jorikdima/sdr-pcb/BOM_sdr.xls

Sheet: bom_full
RefDes | Manufacturer | Manufacturer Part Number | Digi-Key Part Number | Quantity | Description
C1,C101,C107,C109 | YAGEO (VA) | CC0603KRX5R6BB475 | 311-1455-1-ND | 4 | CAP CER 4.7UF 10V X5R 0603
C2,C4,C10-C13,C19,C64-C67 | YAGEO (VA) | CC0603KRX7R7BB474 | 311-1428-1-ND | 11 | CAP CER 0.47UF 16V X7R 0603
C21,C22,C86,C87,C90-C93,C110,C111 | JOHANSON TECHNOLOGY INC (VA) | 251R14S200GV4T | 712-1329-1-ND | 10 | CAP CER 20PF 250V C0G/NP0 0603
C26,C72,C74,C75, C78, C79 | TDK CORPORATION (VA) | C2012X5R1C106K085AC | 445-7644-1-ND | 6 | CAP CER 10UF 16V X5R 0805
C28,C29,C37,C80-C83,C85 | MURATA ELECTRONICS (VA) | GRM188R61C105KA93D | 490-1536-1-ND | 8 | CAP CER 1UF 16V X5R 0603
C3,C5-C9,C14-C18,C20,C23-C25,C27,C30-C33,C35,C36,C38-C40,C44,C46-C48,C50-C53,C55,C57-C63,C84,C88,C102-C104,C106,C108 | YAGEO (VA) | CC0603KRX7R7BB104 | 311-1088-1-ND | 48 | CAP CER 0.1UF 16V X7R 0603
C34,C54,C68-C71 | AVX CORPORATION (VA) | 0603YC330JAT2A | 478-6211-1-ND | 6 | CAP CER 33PF 16V X7R 0603
C41,C43 | KEMET (VA) | C0603C471K3RACTU | 399-9086-1-ND | 2 | CAP CER 470PF 25V X7R 0603
C42,C45,C105 | MURATA ELECTRONICS (VA) | GRM188R71E103KA01D | 490-1520-1-ND | 3 | CAP CER 10000PF 25V X7R 0603
C49,C56 | KEMET (VA) | C0603C151K3GACTU | 399-9008-1-ND | 2 | CAP CER 150PF 25V C0G/NP0 0603
C73,C100 | KEMET (VA) | CBR06C689CAGAC | 399-8719-1-ND | 2 | CAP CER 6.8PF 250V C0G/NP0 0603
C76,C77,C94 | AVX CORPORATION (VA) | 0603YC101KAT2A | 478-6207-1-ND | 3 | CAP CER 100PF 16V X7R 0603
C89,C95-C99 | MURATA ELECTRONICS (VA) | GQM1885C2A3R6CB01D | 490-8135-1-ND | 6 | CAP CER 3.6PF 100V C0G/NP0 0603
D1,D2 | INFINEON TECHNOLOGIES (VA) | ESD0P8RFL E6327 | ESD0P8RFLE6327INCT-ND | 2 | TVS DIODE 50VWM 15VC TSLP4
D3 | DIALIGHT | 5512509F | 350-1682-ND | 1 | LED 3MM RTANG HI EFF ORANGE PCMT
D4 | DIALIGHT | 5510209F | 350-1665-ND | 1 | LED 3MM RT ANG HI EFF GRN PC MNT
D5 | LITE-ON INC (VA) | LTST-C190GKT | 160-1183-1-ND | 1 | LED GREEN CLEAR 0603 SMD
D6 | LITE-ON INC (VA) | LTST-C190EKT | 160-1182-1-ND | 1 | LED RED CLEAR 0603 SMD
D7 | ON SEMICONDUCTOR (VA) | ESD7016MUTAG | ESD7016MUTAGOSCT-ND | 1 | TVS DIODE 5VWM 10VC 8UDFN
J1,J2 | MOLEX, LLC | 0732511150 | WM5534-ND | 2 | CONN SMA RCPT STR 50OHM EDGE MNT
JP1,JP2 | MOLEX, LLC (VA) | M20-9960245 | 952-2244-ND | 2 | CONN HEADER 20POS .100 R/A TIN
L1,L3,L13,L14 | MURATA ELECTRONICS (VA) | BLM18KG601SN1D | 490-5258-1-ND | 4 | FERRITE BEAD 600 OHM 0603 1LN
L2,L6,L7,L10 | MURATA ELECTRONICS (VA) | LQW18AN36NG00D | 490-6886-1-ND | 4 | FIXED IND 36NH 400MA 260 MOHM
L4 | MURATA ELECTRONICS (VA) | LQH3NPN2R2MMEL | 490-15950-1-ND | 1 | FIXED IND 2.2UH 2.1A 78 MOHM
L5 | ABRACON LLC (VA) | ASPI-4030S-4R7M-T | 535-12322-1-ND | 1 | FIXED IND 4.7UH 2A 60 MOHM SMD
L8,L9,L11,L12 | ABRACON LLC (VA) | AIMC-0603-2N7S-T | 535-11536-1-ND | 4 | FIXED IND 2.7NH 500MA 100 MOHM
R1 | YAGEO (VA) | RC0603FR-071K6L | 311-1.60KHRCT-ND | 1 | RES SMD 1.6K OHM 1% 1/10W 0603
R10,R12,R40,R41 | YAGEO (VA) | RC0603JR-07820RL | 311-820GRCT-ND | 4 | RES SMD 820 OHM 5% 1/10W 0603
R11,R13 | YAGEO (VA) | RC0603JR-071K2L | 311-1.2KGRCT-ND | 2 | RES SMD 1.2K OHM 5% 1/10W 0603
R14,R38,R39 | YAGEO (VA) | RC0603JR-07390RL | 311-390GRCT-ND | 3 | RES SMD 390 OHM 5% 1/10W 0603
R16 | YAGEO (VA) | AC0603JR-076K8L | YAG3686CT-ND | 1 | RES SMD 6.8K OHM 5% 1/10W 0603
R2,R26,R28,R30-R32,R37 | YAGEO (VA) | RC0603JR-0710KL | 311-10KGRCT-ND | 7 | RES SMD 10K OHM 5% 1/10W 0603
R22,R23 | YAGEO (VA) | RC0603FR-07120KL | 311-120KHRCT-ND | 2 | RES SMD 120K OHM 1% 1/10W 0603
R24 | YAGEO (VA) | RC0603FR-07100KL | 311-100KHRCT-ND | 1 | RES SMD 100K OHM 1% 1/10W 0603
R25 | YAGEO (VA) | RC0603FR-07560KL | 311-560KHRCT-ND | 1 | RES SMD 560K OHM 1% 1/10W 0603
R3,R17-R20,R27 | YAGEO (VA) | RC0603JR-071KL | 311-1.0KGRCT-ND | 6 | RES SMD 1K OHM 5% 1/10W 0603
R35 | YAGEO (VA) | RC0603JR-072KL | 311-2.0KGRCT-ND | 1 | RES SMD 2K OHM 5% 1/10W 0603
R15,R36 | YAGEO (VA) | RC0603FR-0712KL | 311-12.0KHRCT-ND | 2 | RES SMD 12K OHM 1% 1/10W 0603
R42-R45 | YAGEO (VA) | RC0603JR-070RL | 311-0.0GRCT-ND | 4 | RES SMD 0.0OHM JUMPER 1/10W 0603
R4-R7,R29 | YAGEO (VA) | RC0603JR-074K7L | 311-4.7KGRCT-ND | 5 | RES SMD 4.7K OHM 5% 1/10W 0603
R9,R21,R33,R34 | YAGEO (VA) | RC0603JR-0722RL | 311-22GRCT-ND | 4 | RES SMD 22 OHM 5% 1/10W 0603
S1 | HARWIN INC (VA) | S1711-46R | 952-1475-1-ND | 4 | RFI SHIELD CLIP TIN SMD
SW1 | C&K (VA) | KMR231NG LFS | CKN10246CT-ND | 1 | SWITCH TACTILE SPST-NO 0.05A 32V
T1,T2 | ANAREN MICROWAVE INC (VA) | B0322J5050AHF | 1173-1051-1-ND | 2 | XFRMR BALUN RF 300-2200MHZ 0805
T3,T4 | MINICIRCUITS | TR_TC1-1-43X+ | TR_TC1-1-43X+ | 2
TP1,TP2 | KEYSTONE ELECTRONICS | 5029 | 36-5029CT-ND | 2 | PC TEST POINT MINI SMD
U1 | FTDI | FT601Q-B-T | 768-1311-ND | 1 | IC USB3-32BIT SYNC FIFO 76QFN
U10 | MICROCHIP TECHNOLOGY (VA) | MIC94310-JYMT-TR | 576-4124-1-ND | 1 | IC REG LDO 2.5V 0.2A 4TMLF
U12,U13 | INFINEON TECHNOLOGIES (VA) | BGS12PL6E6327XTSA1 | BGS12PL6E6327XTSA1CT-ND | 2 | IC SWITCH RF SPDT TSLP6-4
U14 | FTDI (VA) | FT232HL-REEL | 768-1101-1-ND | 1 | IC HS USB TO UART/FIFO 48LQFP
U15 | MICROCHIP TECHNOLOGY (VA) | 93LC56BT-I/OT | 93LC56BT-I/OTCT-ND | 1 | IC EEPROM 2KBIT 2MHZ SOT23-6
U3 | LIME MICROSYSTEMS LTD (VA) | LMS6002DFN | 1434-1000-1-ND | 1 | IC RF TXRX CELLULAR 120-VFQFN
U4 | LATTICE SEMICONDUCTOR CORPORATION | LFE5U-25F-6BG381I | 220-2052-ND | 1 | IC FPGA 197 I/O 381CABGA
U5 | SILICON LABORATORIES INC | SI5351A-B-GT | 336-2399-5-ND | 1 | IC CLK GENERATOR 200MHZ 10MSOP
U6,U11 | DIODES INCORPORATED (VA) | PAM2305DABADJ | PAM2305DABADJDICT-ND | 2 | IC REG BUCK ADJ 1A SYNC TSOT25
U7 | STMICROELECTRONICS (VA) | LD39200PU33R | 497-15229-1-ND | 1 | IC REG LINEAR 3.3V 2A 6DFN
U8,U9 | MICROCHIP TECHNOLOGY (VA) | MIC94310-GYMT-TR | 576-4012-1-ND | 2 | IC REG LDO 1.8V 0.2A 4TMLF
X1 | AMPHENOL COMMERCIAL PRODUCTS (VA) | GSB443133HR | GSB443133HRCT-ND | 1 | USB3.1 MICRO B R/A SMT 30U
X2 | SULLINS CONNECTOR SOLUTIONS (VA) | GRPB081VWVN-RC | S9014E-08-ND | 1 | CONN HEADER .050" 8POS PCB GOLD
X3 | SULLINS CONNECTOR SOLUTIONS (VA) | SFH11-PBPC-D20-ST-BK | S9200-ND | 1 | CONN HEADR FMALE 40POS .1" DL AU
X4 | SULLINS CONNECTOR SOLUTIONS (VA) | GRPB051VWVN-RC | S9014E-05-ND | 1 | CONN HEADER .050" 5POS PCB GOLD
X5 | HIROSE ELECTRIC CO LTD (VA) | UX60-MB-5ST | H2959CT-ND | 1 | CONN RECEPT MINI USB2.0 5POS
Y1 | DIODES INCORPORATED (VA) | FL3000027 | FL3000027CT-ND | 1 | CRYSTAL 30MHZ 20PF SMD
Y2 | ABRACON LLC (VA) | ABM11-141-26.000MHZ-T3 | 535-13523-1-ND | 1 | CRYSTAL 26.00MHZ 8PF LOW ESR SMD
Y3 | ABRACON LLC (VA) | ABLS2-12.000MHZ-D4Y-T | 535-9869-1-ND | 1 | CRYSTAL 12.0000MHZ 18PF SMD

Sheet: bom_both
RefDes | Manufacturer | Manufacturer Part Number | Digi-Key Part Number | Quantity | Description
C1,C101,C107,C109 | YAGEO (VA) | CC0603KRX5R6BB475 | 311-1455-1-ND | 4 | CAP CER 4.7UF 10V X5R 0603
C2,C4,C10-C13,C19,C64-C67 | YAGEO (VA) | CC0603KRX7R7BB474 | 311-1428-1-ND | 11 | CAP CER 0.47UF 16V X7R 0603
C21,C22,C86,C87,C90-C93,C110,C111 | JOHANSON TECHNOLOGY INC (VA) | 251R14S200GV4T | 712-1329-1-ND | 10 | CAP CER 20PF 250V C0G/NP0 0603
C26,C72,C74,C75, C78, C79 | TDK CORPORATION (VA) | C2012X5R1C106K085AC | 445-7644-1-ND | 6 | CAP CER 10UF 16V X5R 0805
C28,C29,C37,C80-C83,C85 | MURATA ELECTRONICS (VA) | GRM188R61C105KA93D | 490-1536-1-ND | 8 | CAP CER 1UF 16V X5R 0603
C3,C5-C9,C14-C18,C20,C23-C25,C27,C30-C33,C35,C36,C38-C40,C44,C46-C48,C50-C53,C55,C57-C63,C84,C88,C102-C104,C106,C108 | YAGEO (VA) | CC0603KRX7R7BB104 | 311-1088-1-ND | 48 | CAP CER 0.1UF 16V X7R 0603
C34,C54,C68-C71 | AVX CORPORATION (VA) | 0603YC330JAT2A | 478-6211-1-ND | 6 | CAP CER 33PF 16V X7R 0603
C41,C43 | KEMET (VA) | C0603C471K3RACTU | 399-9086-1-ND | 2 | CAP CER 470PF 25V X7R 0603
C42,C45,C105 | MURATA ELECTRONICS (VA) | GRM188R71E103KA01D | 490-1520-1-ND | 3 | CAP CER 10000PF 25V X7R 0603
C49,C56 | KEMET (VA) | C0603C151K3GACTU | 399-9008-1-ND | 2 | CAP CER 150PF 25V C0G/NP0 0603
C73,C100 | KEMET (VA) | CBR06C689CAGAC | 399-8719-1-ND | 2 | CAP CER 6.8PF 250V C0G/NP0 0603
C76,C77,C94 | AVX CORPORATION (VA) | 0603YC101KAT2A | 478-6207-1-ND | 3 | CAP CER 100PF 16V X7R 0603
C89,C95-C99 | MURATA ELECTRONICS (VA) | GQM1885C2A3R6CB01D | 490-8135-1-ND | 6 | CAP CER 3.6PF 100V C0G/NP0 0603
D1,D2 | INFINEON TECHNOLOGIES (VA) | ESD0P8RFL E6327 | ESD0P8RFLE6327INCT-ND | 2 | TVS DIODE 50VWM 15VC TSLP4
D3 | DIALIGHT | 5512509F | 350-1682-ND | 1 | LED 3MM RTANG HI EFF ORANGE PCMT
D4 | DIALIGHT | 5510209F | 350-1665-ND | 1 | LED 3MM RT ANG HI EFF GRN PC MNT
D5 | LITE-ON INC (VA) | LTST-C190GKT | 160-1183-1-ND | 1 | LED GREEN CLEAR 0603 SMD
D6 | LITE-ON INC (VA) | LTST-C190EKT | 160-1182-1-ND | 1 | LED RED CLEAR 0603 SMD
D7 | ON SEMICONDUCTOR (VA) | ESD7016MUTAG | ESD7016MUTAGOSCT-ND | 1 | TVS DIODE 5VWM 10VC 8UDFN
J1,J2 | MOLEX, LLC | 0732511150 | WM5534-ND | 2 | CONN SMA RCPT STR 50OHM EDGE MNT
JP1,JP2 | MOLEX, LLC (VA) | M20-9960245 | 952-2244-ND | 2 | CONN HEADER 20POS .100 R/A TIN
L1,L3,L13,L14 | MURATA ELECTRONICS (VA) | BLM18KG601SN1D | 490-5258-1-ND | 4 | FERRITE BEAD 600 OHM 0603 1LN
L2,L6,L7,L10 | MURATA ELECTRONICS (VA) | LQW18AN36NG00D | 490-6886-1-ND | 4 | FIXED IND 36NH 400MA 260 MOHM
L4 | MURATA ELECTRONICS (VA) | LQH3NPN2R2MMEL | 490-15950-1-ND | 1 | FIXED IND 2.2UH 2.1A 78 MOHM
L5 | ABRACON LLC (VA) | ASPI-4030S-4R7M-T | 535-12322-1-ND | 1 | FIXED IND 4.7UH 2A 60 MOHM SMD
L8,L9,L11,L12 | ABRACON LLC (VA) | AIMC-0603-2N7S-T | 535-11536-1-ND | 4 | FIXED IND 2.7NH 500MA 100 MOHM
R1 | YAGEO (VA) | RC0603FR-071K6L | 311-1.60KHRCT-ND | 1 | RES SMD 1.6K OHM 1% 1/10W 0603
R10,R12,R40,R41 | YAGEO (VA) | RC0603JR-07820RL | 311-820GRCT-ND | 4 | RES SMD 820 OHM 5% 1/10W 0603
R11,R13 | YAGEO (VA) | RC0603JR-071K2L | 311-1.2KGRCT-ND | 2 | RES SMD 1.2K OHM 5% 1/10W 0603
R14,R38,R39 | YAGEO (VA) | RC0603JR-07390RL | 311-390GRCT-ND | 3 | RES SMD 390 OHM 5% 1/10W 0603
R16 | YAGEO (VA) | AC0603JR-076K8L | YAG3686CT-ND | 1 | RES SMD 6.8K OHM 5% 1/10W 0603
R2,R26,R28,R30-R32,R37 | YAGEO (VA) | RC0603JR-0710KL | 311-10KGRCT-ND | 7 | RES SMD 10K OHM 5% 1/10W 0603
R22,R23 | YAGEO (VA) | RC0603FR-07120KL | 311-120KHRCT-ND | 2 | RES SMD 120K OHM 1% 1/10W 0603
R24 | YAGEO (VA) | RC0603FR-07100KL | 311-100KHRCT-ND | 1 | RES SMD 100K OHM 1% 1/10W 0603
R25 | YAGEO (VA) | RC0603FR-07560KL | 311-560KHRCT-ND | 1 | RES SMD 560K OHM 1% 1/10W 0603
R3,R17-R20,R27 | YAGEO (VA) | RC0603JR-071KL | 311-1.0KGRCT-ND | 6 | RES SMD 1K OHM 5% 1/10W 0603
R35 | YAGEO (VA) | RC0603JR-072KL | 311-2.0KGRCT-ND | 1 | RES SMD 2K OHM 5% 1/10W 0603
R15,R36 | YAGEO (VA) | RC0603FR-0712KL | 311-12.0KHRCT-ND | 2 | RES SMD 12K OHM 1% 1/10W 0603
R42-R45 | YAGEO (VA) | RC0603JR-070RL | 311-0.0GRCT-ND | 4 | RES SMD 0.0OHM JUMPER 1/10W 0603
R4-R7,R29 | YAGEO (VA) | RC0603JR-074K7L | 311-4.7KGRCT-ND | 5 | RES SMD 4.7K OHM 5% 1/10W 0603
R9,R21,R33,R34 | YAGEO (VA) | RC0603JR-0722RL | 311-22GRCT-ND | 4 | RES SMD 22 OHM 5% 1/10W 0603
SW1 | C&K (VA) | KMR231NG LFS | CKN10246CT-ND | 1 | SWITCH TACTILE SPST-NO 0.05A 32V
T1,T2 | ANAREN MICROWAVE INC (VA) | B0322J5050AHF | 1173-1051-1-ND | 2 | XFRMR BALUN RF 300-2200MHZ 0805
TP1,TP2 | KEYSTONE ELECTRONICS | 5029 | 36-5029CT-ND | 2 | PC TEST POINT MINI SMD
U1 | FTDI | FT601Q-B-T | 768-1311-ND | 1 | IC USB3-32BIT SYNC FIFO 76QFN
U10 | MICROCHIP TECHNOLOGY (VA) | MIC94310-JYMT-TR | 576-4124-1-ND | 1 | IC REG LDO 2.5V 0.2A 4TMLF
U12,U13 | INFINEON TECHNOLOGIES (VA) | BGS12PL6E6327XTSA1 | BGS12PL6E6327XTSA1CT-ND | 2 | IC SWITCH RF SPDT TSLP6-4
U14 | FTDI (VA) | FT232HL-REEL | 768-1101-1-ND | 1 | IC HS USB TO UART/FIFO 48LQFP
U15 | MICROCHIP TECHNOLOGY (VA) | 93LC56BT-I/OT | 93LC56BT-I/OTCT-ND | 1 | IC EEPROM 2KBIT 2MHZ SOT23-6
U3 | LIME MICROSYSTEMS LTD (VA) | LMS6002DFN | 1434-1000-1-ND | 1 | IC RF TXRX CELLULAR 120-VFQFN
U4 | LATTICE SEMICONDUCTOR CORPORATION | LFE5U-25F-6BG381I | 220-2052-ND | 1 | IC FPGA 197 I/O 381CABGA
U5 | SILICON LABORATORIES INC | SI5351A-B-GT | 336-2399-5-ND | 1 | IC CLK GENERATOR 200MHZ 10MSOP
U6,U11 | DIODES INCORPORATED (VA) | PAM2305DABADJ | PAM2305DABADJDICT-ND | 2 | IC REG BUCK ADJ 1A SYNC TSOT25
U7 | STMICROELECTRONICS (VA) | LD39200PU33R | 497-15229-1-ND | 1 | IC REG LINEAR 3.3V 2A 6DFN
U8,U9 | MICROCHIP TECHNOLOGY (VA) | MIC94310-GYMT-TR | 576-4012-1-ND | 2 | IC REG LDO 1.8V 0.2A 4TMLF
X1 | AMPHENOL COMMERCIAL PRODUCTS (VA) | GSB443133HR | GSB443133HRCT-ND | 1 | USB3.1 MICRO B R/A SMT 30U
X5 | HIROSE ELECTRIC CO LTD (VA) | UX60-MB-5ST | H2959CT-ND | 1 | CONN RECEPT MINI USB2.0 5POS
Y1 | DIODES INCORPORATED (VA) | FL3000027 | FL3000027CT-ND | 1 | CRYSTAL 30MHZ 20PF SMD
Y2 | ABRACON LLC (VA) | ABM11-141-26.000MHZ-T3 | 535-13523-1-ND | 1 | CRYSTAL 26.00MHZ 8PF LOW ESR SMD
Y3 | ABRACON LLC (VA) | ABLS2-12.000MHZ-D4Y-T | 535-9869-1-ND | 1 | CRYSTAL 12.0000MHZ 18PF SMD

Sheet: bom_top
RefDes | Manufacturer | Manufacturer Part Number | Digi-Key Part Number | Quantity | Description
C101 | YAGEO (VA) | CC0603KRX5R6BB475 | 311-1455-1-ND | 1 | CAP CER 4.7UF 10V X5R 0603
C21,C22,C86,C87,C90-C93 | JOHANSON TECHNOLOGY INC (VA) | 251R14S200GV4T | 712-1329-1-ND | 8 | CAP CER 20PF 250V C0G/NP0 0603
C80,C81,C83,C85 | MURATA ELECTRONICS (VA) | GRM188R61C105KA93D | 490-1536-1-ND | 4 | CAP CER 1UF 16V X5R 0603
C23,C25,C27,C30,C36,C38,C59 | YAGEO (VA) | CC0603KRX7R7BB104 | 311-1088-1-ND | 7 | CAP CER 0.1UF 16V X7R 0603
C34 | AVX CORPORATION (VA) | 0603YC330JAT2A | 478-6211-1-ND | 1 | CAP CER 33PF 16V X7R 0603
C41,C43 | KEMET (VA) | C0603C471K3RACTU | 399-9086-1-ND | 2 | CAP CER 470PF 25V X7R 0603
C42,C45 | MURATA ELECTRONICS (VA) | GRM188R71E103KA01D | 490-1520-1-ND | 2 | CAP CER 10000PF 25V X7R 0603
C49,C56 | KEMET (VA) | C0603C151K3GACTU | 399-9008-1-ND | 2 | CAP CER 150PF 25V C0G/NP0 0603
C73,C100 | KEMET (VA) | CBR06C689CAGAC | 399-8719-1-ND | 2 | CAP CER 6.8PF 250V C0G/NP0 0603
C77 | AVX CORPORATION (VA) | 0603YC101KAT2A | 478-6207-1-ND | 1 | CAP CER 100PF 16V X7R 0603
C89,C95-C99 | MURATA ELECTRONICS (VA) | GQM1885C2A3R6CB01D | 490-8135-1-ND | 6 | CAP CER 3.6PF 100V C0G/NP0 0603
D1,D2 | INFINEON TECHNOLOGIES (VA) | ESD0P8RFL E6327 | ESD0P8RFLE6327INCT-ND | 2 | TVS DIODE 50VWM 15VC TSLP4
D3 | DIALIGHT | 5512509F | 350-1682-ND | 1 | LED 3MM RTANG HI EFF ORANGE PCMT
D4 | DIALIGHT | 5510209F | 350-1665-ND | 1 | LED 3MM RT ANG HI EFF GRN PC MNT
D5 | LITE-ON INC (VA) | LTST-C190GKT | 160-1183-1-ND | 1 | LED GREEN CLEAR 0603 SMD
D6 | LITE-ON INC (VA) | LTST-C190EKT | 160-1182-1-ND | 1 | LED RED CLEAR 0603 SMD
D7 | ON SEMICONDUCTOR (VA) | ESD7016MUTAG | ESD7016MUTAGOSCT-ND | 1 | TVS DIODE 5VWM 10VC 8UDFN
J1,J2 | MOLEX, LLC | 732511150 | WM5534-ND | 2 | CONN SMA RCPT STR 50OHM EDGE MNT
L2,L6,L7,L10 | MURATA ELECTRONICS (VA) | LQW18AN36NG00D | 490-6886-1-ND | 4 | FIXED IND 36NH 400MA 260 MOHM
L8,L9,L11,L12 | ABRACON LLC (VA) | AIMC-0603-2N7S-T | 535-11536-1-ND | 4 | FIXED IND 2.7NH 500MA 100 MOHM
R10,R12 | YAGEO (VA) | RC0603JR-07820RL | 311-820GRCT-ND | 2 | RES SMD 820 OHM 5% 1/10W 0603
R11,R13 | YAGEO (VA) | RC0603JR-071K2L | 311-1.2KGRCT-ND | 2 | RES SMD 1.2K OHM 5% 1/10W 0603
R30-R31 | YAGEO (VA) | RC0603JR-0710KL | 311-10KGRCT-ND | 2 | RES SMD 10K OHM 5% 1/10W 0603
R22 | YAGEO (VA) | RC0603FR-07120KL | 311-120KHRCT-ND | 1 | RES SMD 120K OHM 1% 1/10W 0603
SW1 | C&K (VA) | KMR231NG LFS | CKN10246CT-ND | 1 | SWITCH TACTILE SPST-NO 0.05A 32V
T1,T2 | ANAREN MICROWAVE INC (VA) | B0322J5050AHF | 1173-1051-1-ND | 2 | XFRMR BALUN RF 300-2200MHZ 0805
TP1,TP2 | KEYSTONE ELECTRONICS | 5029 | 36-5029CT-ND | 2 | PC TEST POINT MINI SMD
U1 | FTDI | FT601Q-B-T | 768-1311-ND | 1 | IC USB3-32BIT SYNC FIFO 76QFN
U10 | MICROCHIP TECHNOLOGY (VA) | MIC94310-JYMT-TR | 576-4124-1-ND | 1 | IC REG LDO 2.5V 0.2A 4TMLF
U12,U13 | INFINEON TECHNOLOGIES (VA) | BGS12PL6E6327XTSA1 | BGS12PL6E6327XTSA1CT-ND | 2 | IC SWITCH RF SPDT TSLP6-4
U14 | FTDI (VA) | FT232HL-REEL | 768-1101-1-ND | 1 | IC HS USB TO UART/FIFO 48LQFP
U15 | MICROCHIP TECHNOLOGY (VA) | 93LC56BT-I/OT | 93LC56BT-I/OTCT-ND | 1 | IC EEPROM 2KBIT 2MHZ SOT23-6
U3 | LIME MICROSYSTEMS LTD (VA) | LMS6002DFN | 1434-1000-1-ND | 1 | IC RF TXRX CELLULAR 120-VFQFN
U4 | LATTICE SEMICONDUCTOR CORPORATION | LFE5U-25F-6BG381I | 220-2052-ND | 1 | IC FPGA 197 I/O 381CABGA
U5 | SILICON LABORATORIES INC | SI5351A-B-GT | 336-2399-5-ND | 1 | IC CLK GENERATOR 200MHZ 10MSOP
U8,U9 | MICROCHIP TECHNOLOGY (VA) | MIC94310-GYMT-TR | 576-4012-1-ND | 2 | IC REG LDO 1.8V 0.2A 4TMLF
X1 | AMPHENOL COMMERCIAL PRODUCTS (VA) | GSB443133HR | GSB443133HRCT-ND | 1 | USB3.1 MICRO B R/A SMT 30U
X5 | HIROSE ELECTRIC CO LTD (VA) | UX60-MB-5ST | H2959CT-ND | 1 | CONN RECEPT MINI USB2.0 5POS
Y1 | DIODES INCORPORATED (VA) | FL3000027 | FL3000027CT-ND | 1 | CRYSTAL 30MHZ 20PF SMD
Y2 | ABRACON LLC (VA) | ABM11-141-26.000MHZ-T3 | 535-13523-1-ND | 1 | CRYSTAL 26.00MHZ 8PF LOW ESR SMD
Y3 | ABRACON LLC (VA) | ABLS2-12.000MHZ-D4Y-T | 535-9869-1-ND | 1 | CRYSTAL 12.0000MHZ 18PF SMD
