jorikdima/sdr-pcb/sdr.kicad_pcb

## KiCad design sdr.kicad_pcb (2017-08-25)

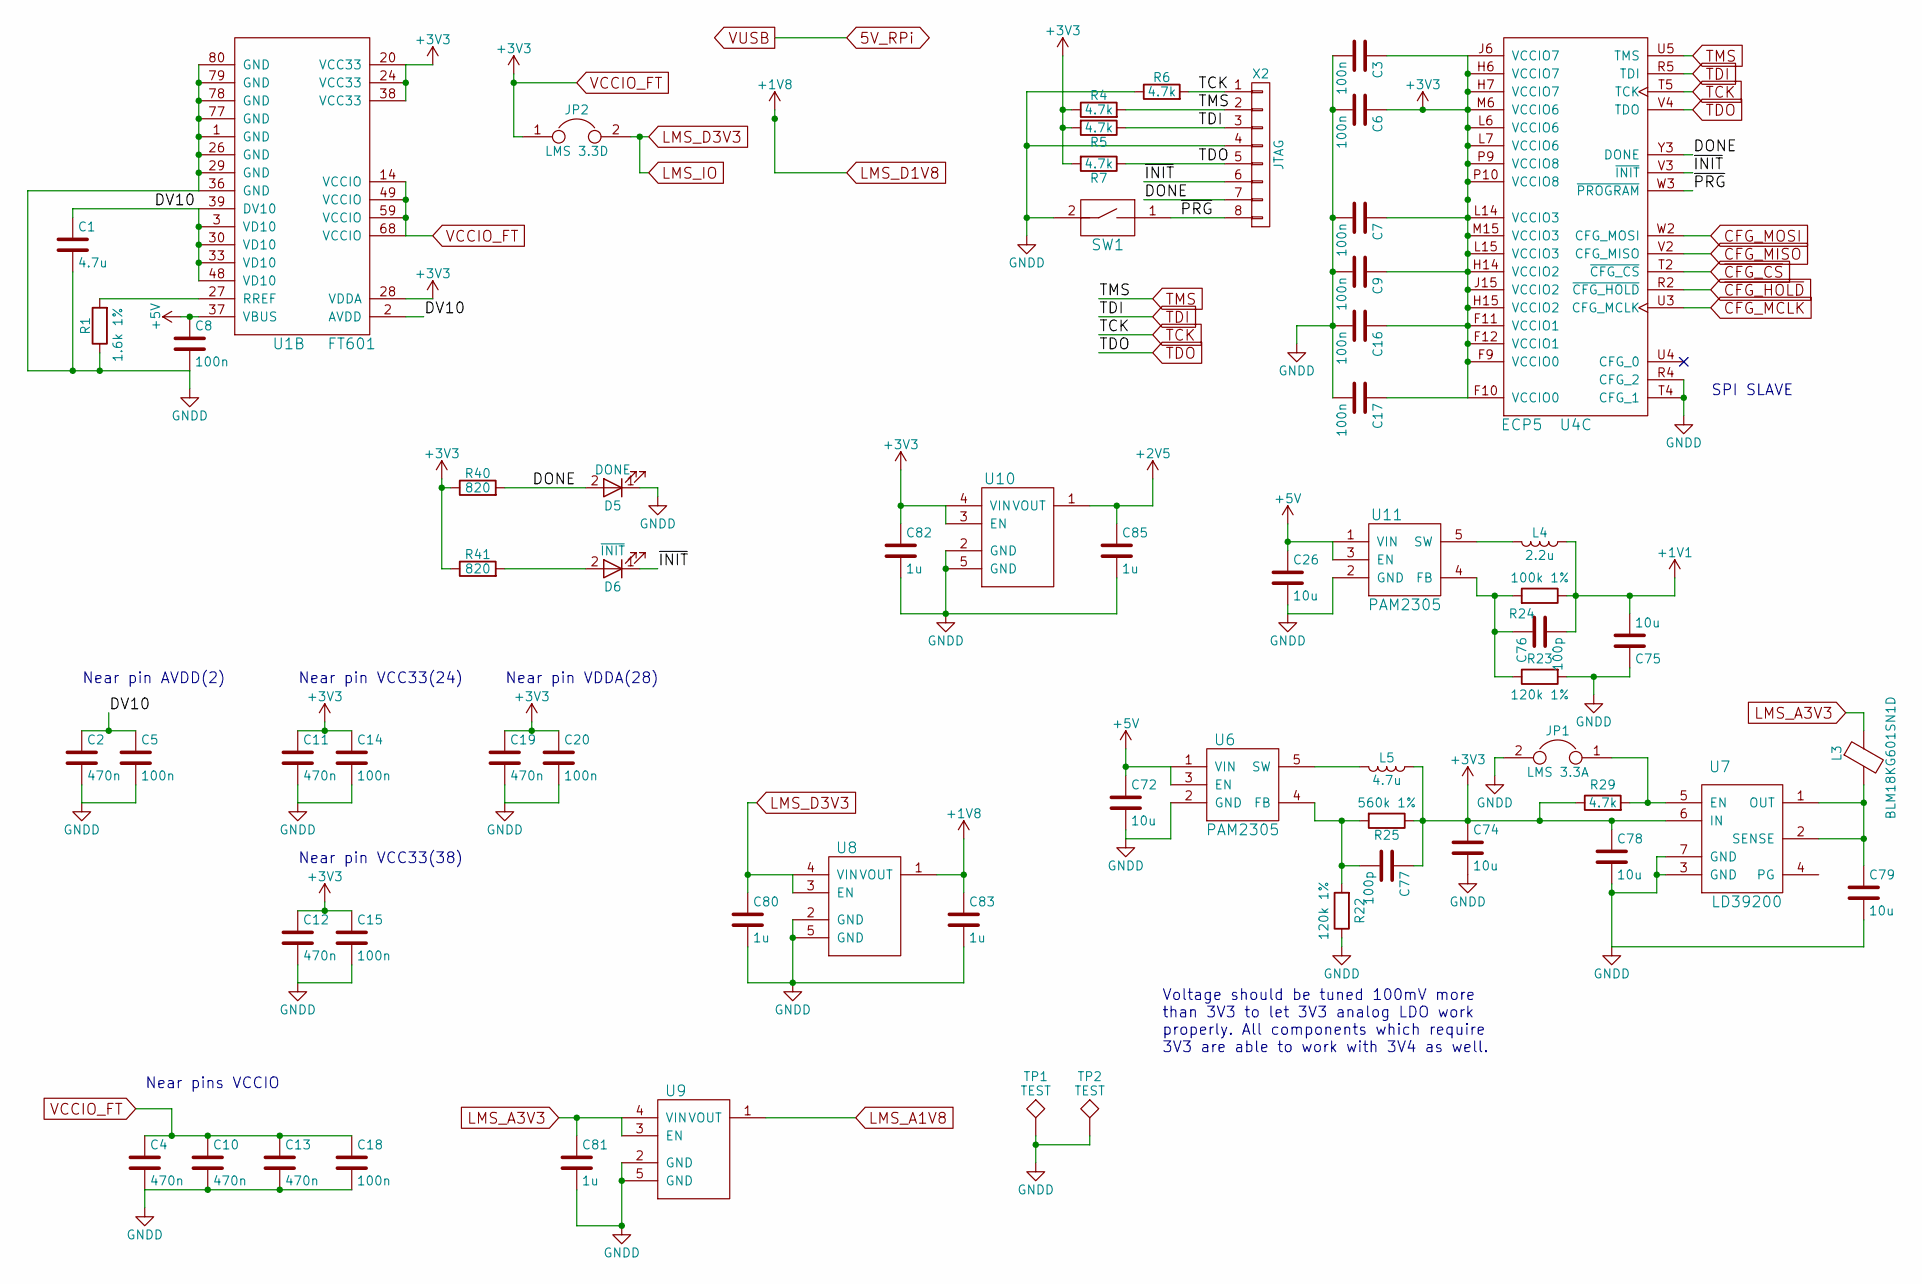
[picture p1: schematic pwr.sch, SDR]

Parts:
C1: 4.7u; C_0603
C2, C4, C10, C11, C12, C13, C19: 470n; C_0603
C3, C5, C6, C7, C8, C9, C14, C15, C16, C17, C18, C20: 100n; C_0603
C26, C72, C74, C75, C78, C79: 10u; C_0805
C76, C77: 100p; C_0603
C80, C81, C82, C83, C85: 1u; C_0603
D5: DONE; LED_0603
D6: ~INIT; LED_0603
JP1: LMS 3.3A; Pin_Header_Angled_1x02_Pitch2.54mm
JP2: LMS 3.3D; Pin_Header_Angled_1x02_Pitch2.54mm
L3: BLM18KG601SN1D; L_0805
L4: 2.2u; Inductor_Taiyo-Yuden_MD-4040
L5: 4.7u; Inductor_Taiyo-Yuden_MD-4040
R1: 1.6k 1%; R_0603
R4, R5, R6, R7, R29: 4.7k; R_0603
R22, R23: 120k 1%; R_0603
R24: 100k 1%; R_0603
R25: 560k 1%; R_0603
R40, R41: 820; R_0603
SW1: KMR231NGLFS; Switch_KMR2
TP1, TP2: TEST; Test_Point_Keystone_5015_Micro-Minature
U1: FT601; QFN_76
U4: ECP5; ECP5_381
U6, U11: PAM2305; SOT-23-5
U7: LD39200; DFN-6-1EP_3x3mm_Pitch0.95mm
U8, U9, U10: MIC94310; DFN-4
X2: JTAG; Pin_Header_Straight_1x08_Pitch1.27mm

Connections:
+1V1: C75.2, C76.2, L4.2, R24.1; also elsewhere on the board
+2V5: C85.1, U10.1 (VOUT); also elsewhere on the board
+5V: C8.1, C26.1, C72.1, U1.37 (VBUS), U6.1 (VIN), U6.3 (EN), U11.1 (VIN), U11.3 (EN); also elsewhere on the board
/Power/DONE: D5.2 (A), R40.2, U4.Y3 (DONE), X2.7
/Power/DV10: C1.1, C2.1, C5.1, U1.2 (AVDD), U1.3 (VD10), U1.30 (VD10), U1.33 (VD10), U1.39 (DV10), U1.48 (VD10)
/Power/~INIT: D6.1 (K), U4.V3 (~INIT), X2.6
/Power/~PRG: SW1.1, U4.W3 (~PROGRAM), X2.8
CFG_MCLK: U4.U3 (CFG_MCLK); also elsewhere on the board
CFG_MISO: U4.V2 (CFG_MISO); also elsewhere on the board
CFG_MOSI: U4.W2 (CFG_MOSI); also elsewhere on the board
FT_GPIO1: U4.T2 (~CFG_CS); also elsewhere on the board
LMS_A1V8: U9.1 (VOUT); also elsewhere on the board
LMS_A3V3: C81.1, L3.1, U9.3 (EN), U9.4 (VIN); also elsewhere on the board
LMS_D1V8: C83.1, U8.1 (VOUT); also elsewhere on the board
LMS_D3V3: C80.1, JP2.2, U8.3 (EN), U8.4 (VIN); also elsewhere on the board
unnamed: C76.1, R23.1, R24.2, U11.4 (FB)
unnamed: C77.2, R22.2, R25.2, U6.4 (FB)
unnamed: C79.1, L3.2, U7.1 (OUT), U7.2 (SENSE)
unnamed: D6.2 (A), R41.2
unnamed: JP1.1, R29.2, U7.5 (EN)
unnamed: L4.1, U11.5 (SW)
unnamed: L5.2, U6.5 (SW)
unnamed: R1.2, U1.27 (RREF)
TCK: R6.2, U4.T5 (TCK), X2.1; also elsewhere on the board
TDI: R5.1, U4.R5 (TDI), X2.3; also elsewhere on the board
TDO: R7.1, U4.V4 (TDO), X2.5; also elsewhere on the board
TMS: R4.2, U4.U5 (TMS), X2.2; also elsewhere on the board
VCCIO_FT: C3.1, C4.1, C6.1, C7.1, C9.1, C10.1, C11.1, C12.1, C13.1, C14.1, C15.1, C16.1, C17.1, C18.1, C19.1, C20.1, C74.1, C77.1, C78.1, C82.1, JP2.1, L5.1, R4.1, R5.2, R7.2, R25.1, R29.1, R40.1, R41.1, U1.14 (VCCIO), U1.20 (VCC33), U1.24 (VCC33), U1.28 (VDDA), U1.38 (VCC33), U1.49 (VCCIO), U1.59 (VCCIO), U1.68 (VCCIO), U4.F9 (VCCIO0), U4.F10 (VCCIO0), U4.F11 (VCCIO1), U4.F12 (VCCIO1), U4.H6 (VCCIO7), U4.H7 (VCCIO7), U4.H14 (VCCIO2), U4.H15 (VCCIO2), U4.J6 (VCCIO7), U4.J15 (VCCIO2), U4.L6 (VCCIO6), U4.L7 (VCCIO6), U4.L14 (VCCIO3), U4.L15 (VCCIO3), U4.M6 (VCCIO6), U4.M15 (VCCIO3), U4.P9 (VCCIO8), U4.P10 (VCCIO8), U7.6 (IN), U10.3 (EN), U10.4 (VIN); also elsewhere on the board
~CFG_HOLD: U4.R2 (~CFG_HOLD); also elsewhere on the board

Notes on the sheet:
Near pin AVDD(2)
Near pin VCC33(38)
Near pin VDDA(28)
Near pin VCC33(24)
Near pins VCCIO
SPI SLAVE
Voltage should be tuned 100mV more than 3V3 to let 3V3 analog LDO work properly. All components which require 3V3 are able to work with 3V4 as well.

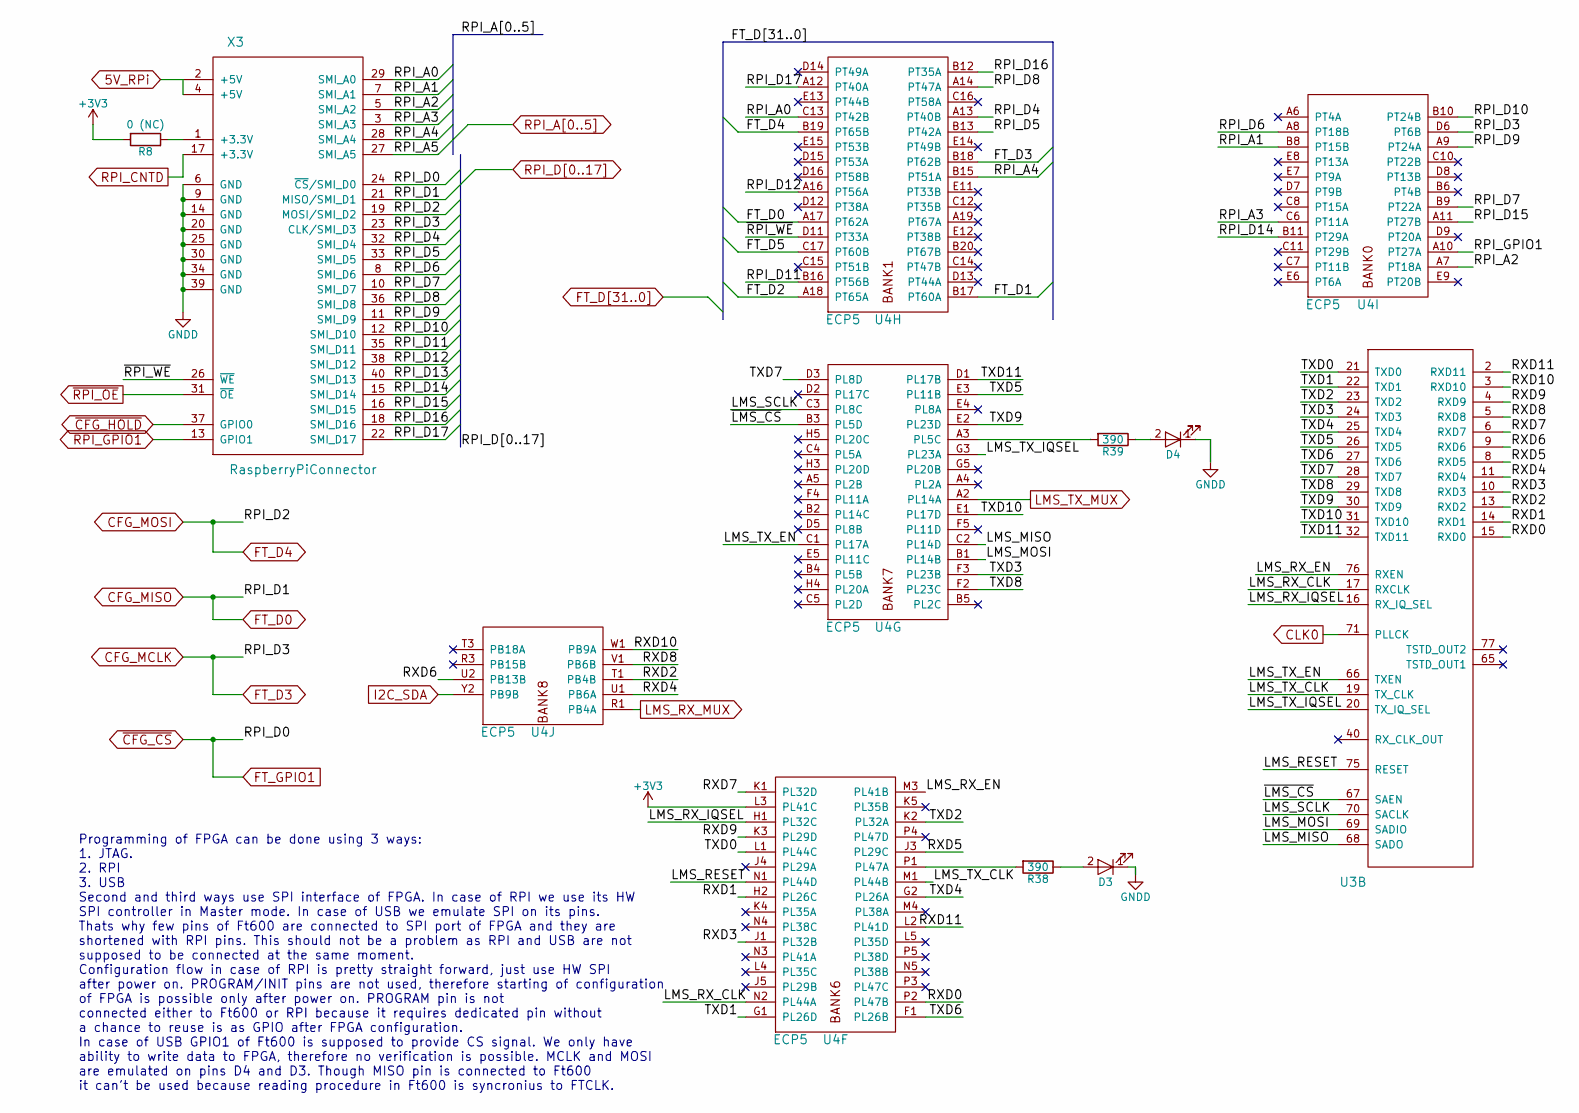
[picture p2: schematic RPi.sch, SDR]

Parts:
D3: 5512509F; LED_IND_SINGLE
D4: 5510209F; LED_IND_SINGLE
R8: 0 (NC); R_0603
R38, R39: 390; R_0603
U3: LMS6002DR2; DQFN-120_via_off_pad
U4: ECP5; ECP5_381
X3: RaspberryPiConnector; Socket_Strip_Straight_2x20_Pitch2.54mm

Connections:
/RPi/LMS/LMS_MISO: U3.68 (SADO), U4.C2 (PL14D)
/RPi/LMS/LMS_MOSI: U3.69 (SADIO), U4.B1 (PL14B)
/RPi/LMS/LMS_RESET: U3.75 (RESET), U4.N1 (PL44D)
/RPi/LMS/LMS_RX_CLK: U3.17 (RXCLK), U4.N2 (PL44A)
/RPi/LMS/LMS_RX_EN: U3.76 (RXEN), U4.M3 (PL41B)
/RPi/LMS/LMS_RX_IQSEL: U3.16 (RX_IQ_SEL), U4.H1 (PL32C)
/RPi/LMS/LMS_SCLK: U3.70 (SACLK), U4.C3 (PL8C)
/RPi/LMS/LMS_TX_CLK: U3.19 (TX_CLK), U4.M1 (PL44B)
/RPi/LMS/LMS_TX_EN: U3.66 (TXEN), U4.C1 (PL17A)
/RPi/LMS/LMS_TX_IQSEL: U3.20 (TX_IQ_SEL), U4.G3 (PL23A)
/RPi/LMS/RXD0: U3.15 (RXD0), U4.P2 (PL47B)
/RPi/LMS/RXD1: U3.14 (RXD1), U4.H2 (PL26C)
/RPi/LMS/RXD2: U3.13 (RXD2), U4.T1 (PB4B)
/RPi/LMS/RXD3: U3.10 (RXD3), U4.J1 (PL32B)
/RPi/LMS/RXD4: U3.11 (RXD4), U4.U1 (PB6A)
/RPi/LMS/RXD5: U3.8 (RXD5), U4.J3 (PL29C)
/RPi/LMS/RXD6: U3.9 (RXD6), U4.U2 (PB13B)
/RPi/LMS/RXD7: U3.6 (RXD7), U4.K1 (PL32D)
/RPi/LMS/RXD8: U3.5 (RXD8), U4.V1 (PB6B)
/RPi/LMS/RXD9: U3.4 (RXD9), U4.K3 (PL29D)
/RPi/LMS/RXD10: U3.3 (RXD10), U4.W1 (PB9A)
/RPi/LMS/RXD11: U3.2 (RXD11), U4.L2 (PL41D)
/RPi/LMS/TXD0: U3.21 (TXD0), U4.L1 (PL44C)
/RPi/LMS/TXD1: U3.22 (TXD1), U4.G1 (PL26D)
/RPi/LMS/TXD2: U3.23 (TXD2), U4.K2 (PL32A)
/RPi/LMS/TXD3: U3.24 (TXD3), U4.F3 (PL23B)
/RPi/LMS/TXD4: U3.25 (TXD4), U4.G2 (PL26A)
/RPi/LMS/TXD5: U3.26 (TXD5), U4.E3 (PL11B)
/RPi/LMS/TXD6: U3.27 (TXD6), U4.F1 (PL26B)
/RPi/LMS/TXD7: U3.28 (TXD7), U4.D3 (PL8D)
/RPi/LMS/TXD8: U3.29 (TXD8), U4.F2 (PL23C)
/RPi/LMS/TXD9: U3.30 (TXD9), U4.E2 (PL23D)
/RPi/LMS/TXD10: U3.31 (TXD10), U4.E1 (PL17D)
/RPi/LMS/TXD11: U3.32 (TXD11), U4.D1 (PL17B)
/RPi/LMS/~LMS_CS: U3.67 (SAEN), U4.B3 (PL5D)
/RPi/LMS/~RPI_WE: U4.D11 (PT33A), X3.26 (~WE)
CFG_MCLK: U4.B18 (PT62B), U4.D6 (PT6B), X3.23 (CLK/SMI_D3); also elsewhere on the board
CFG_MISO: U4.A17 (PT62A), X3.21 (MISO/SMI_D1); also elsewhere on the board
CFG_MOSI: U4.B19 (PT65B), X3.19 (MOSI/SMI_D2); also elsewhere on the board
CLK0: U3.71 (PLLCK); also elsewhere on the board
FT_D1: U4.B17 (PT60A); also elsewhere on the board
FT_D2: U4.A18 (PT65A); also elsewhere on the board
FT_D5: U4.C17 (PT60B); also elsewhere on the board
FT_GPIO1: X3.24 (~CS~/SMI_D0); also elsewhere on the board
I2C_SDA: U4.Y2 (PB9B); also elsewhere on the board
LMS_RX_MUX: U4.R1 (PB4A); also elsewhere on the board
LMS_TX_MUX: U4.A2 (PL14A); also elsewhere on the board
unnamed: D3.2 (A), R38.1
unnamed: D4.2 (A), R39.1
unnamed: R8.1, X3.1 (+3.3V)
unnamed: R38.2, U4.P1 (PL47A)
unnamed: R39.2, U4.A3 (PL5C)
RPI_A0: U4.C13 (PT42B), X3.29 (SMI_A0)
RPI_A1: U4.B8 (PT15B), X3.7 (SMI_A1)
RPI_A2: U4.A7 (PT18A), X3.5 (SMI_A2)
RPI_A3: U4.C6 (PT11A), X3.3 (SMI_A3)
RPI_A4: U4.B15 (PT51A), X3.28 (SMI_A4)
RPI_A5: X3.27 (SMI_A5); also elsewhere on the board
RPI_CNTD: X3.17 (+3.3V); also elsewhere on the board
RPI_D4: U4.A13 (PT40B), X3.32 (SMI_D4)
RPI_D5: U4.B13 (PT42A), X3.33 (SMI_D5)
RPI_D6: U4.A8 (PT18B), X3.8 (SMI_D6)
RPI_D7: U4.B9 (PT22A), X3.10 (SMI_D7)
RPI_D8: U4.A14 (PT47A), X3.36 (SMI_D8)
RPI_D9: U4.A9 (PT24A), X3.11 (SMI_D9)
RPI_D10: U4.B10 (PT24B), X3.12 (SMI_D10)
RPI_D11: U4.B16 (PT56B), X3.35 (SMI_D11)
RPI_D12: U4.A16 (PT56A), X3.38 (SMI_D12)
RPI_D13: X3.40 (SMI_D13); also elsewhere on the board
RPI_D14: U4.B11 (PT29A), X3.15 (SMI_D14)
RPI_D15: U4.A11 (PT27B), X3.16 (SMI_D15)
RPI_D16: U4.B12 (PT35A), X3.18 (SMI_D16)
RPI_D17: U4.A12 (PT40A), X3.22 (SMI_D17)
RPI_GPIO1: U4.A10 (PT27A), X3.13 (GPIO1)
VCCIO_FT: R8.2, U4.L3 (PL41C); also elsewhere on the board
~CFG_HOLD: X3.37 (GPIO0); also elsewhere on the board
~RPI_OE: X3.31 (~OE); also elsewhere on the board

Notes on the sheet:
Programming of FPGA can be done using 3 ways: 1. JTAG. 2. RPI 3. USB Second and third ways use SPI interface of FPGA. In case of RPI we use its HW SPI controller in Master mode. In case of USB we emulate SPI on its pins. Thats why few pins of Ft600 are connected to SPI port of FPGA and they are sho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

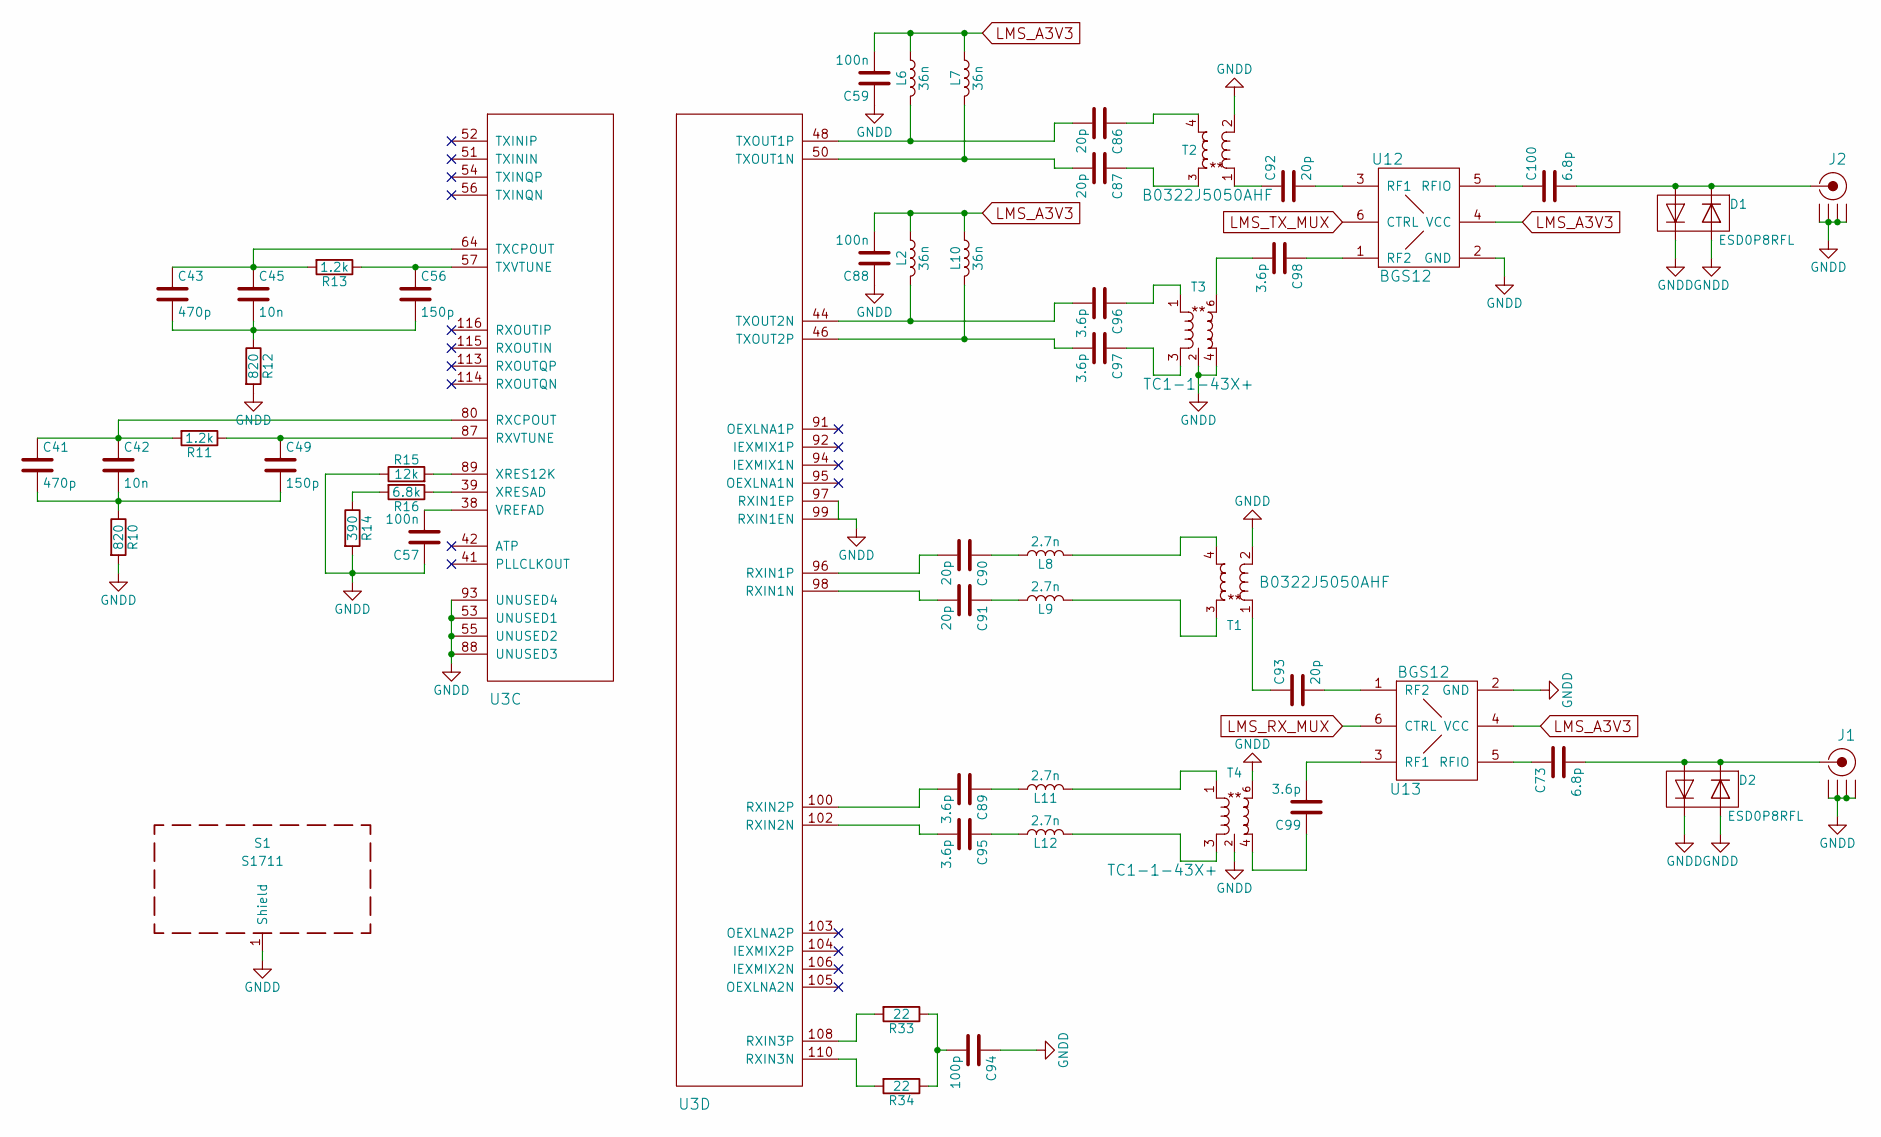
[picture p3: schematic LMS6002.sch, SDR]

Parts:
C41, C43: 470p; C_0603
C42, C45: 10n; C_0603
C49, C56: 150p; C_0603
C57, C59, C88: 100n; C_0603
C73, C100: 6.8p; C_0603
C86, C87, C90, C91, C92, C93: 20p; C_0603
C89, C95, C96, C97, C98, C99: 3.6p; C_0603
C94: 100p; C_0603
D1, D2: ESD0P8RFL; TSLP-4-7
J1: RX; SMA_H
J2: TX; SMA_H
L2, L6, L7, L10: 36n; L_0603
L8, L9, L11, L12: 2.7n; L_0603
R10, R12: 820; R_0603
R11, R13: 1.2k; R_0603
R14: 390; R_0603
R15: 12k; R_0603
R16: 6.8k; R_0603
R33, R34: 22; R_0603
S1: S1711; SHIELD
T1, T2: B0322J5050
T3, T4: TR_TC1-1-43X+; TC1-1-43X+; Manufacturer Part Number TC1-1-43X+
U3: LMS6002DR2; DQFN-120_via_off_pad; Manufacturer Part Number LMS6002DFN
U12, U13: BGS12; TSLP-6-4

Connections:
LMS_A3V3: C59.2, C88.2, L2.1, L6.1, L7.1, L10.1, U12.4 (VCC), U13.4 (VCC); also elsewhere on the board
LMS_RX_MUX: U13.6 (CTRL); also elsewhere on the board
LMS_TX_MUX: U12.6 (CTRL); also elsewhere on the board
unnamed: C41.1, C42.1, R11.2, U3.80 (RXCPOUT)
unnamed: C41.2, C42.2, C49.2, R10.1
unnamed: C43.1, C45.1, R13.2, U3.64 (TXCPOUT)
unnamed: C43.2, C45.2, C56.2, R12.1
unnamed: C49.1, R11.1, U3.87 (RXVTUNE)
unnamed: C56.1, R13.1, U3.57 (TXVTUNE)
unnamed: C57.2, U3.38 (VREFAD)
unnamed: C73.1, U13.5 (RFIO)
unnamed: C86.1, T2.4
unnamed: C86.2, L6.2, U3.48 (TXOUT1P)
unnamed: C87.1, T2.3
unnamed: C87.2, L7.2, U3.50 (TXOUT1N)
unnamed: C89.1, L11.1
unnamed: C89.2, U3.100 (RXIN2P)
unnamed: C90.1, L8.1
unnamed: C90.2, U3.96 (RXIN1P)
unnamed: C91.1, L9.1
unnamed: C91.2, U3.98 (RXIN1N)
unnamed: C92.1, T2.1
unnamed: C92.2, U12.3 (RF1)
unnamed: C93.1, T1.1
unnamed: C93.2, U13.1 (RF2)
unnamed: C94.2, R33.1, R34.1
unnamed: C95.1, L12.1
unnamed: C95.2, U3.102 (RXIN2N)
unnamed: C96.1, T3.1
unnamed: C96.2, L2.2, U3.44 (TXOUT2N)
unnamed: C97.1, T3.3
unnamed: C97.2, L10.2, U3.46 (TXOUT2P)
unnamed: C98.1, U12.1 (RF2)
unnamed: C98.2, T3.6
unnamed: C99.1, T4.4
unnamed: C99.2, U13.3 (RF1)
unnamed: C100.1, U12.5 (RFIO)
unnamed: L8.2, T1.4
unnamed: L9.2, T1.3
unnamed: L11.2, T4.1
unnamed: L12.2, T4.3
unnamed: R14.1, R16.2
unnamed: R15.2, U3.89 (XRES12K)
unnamed: R16.1, U3.39 (XRESAD)
unnamed: R33.2, U3.108 (RXIN3P)
unnamed: R34.2, U3.110 (RXIN3N)

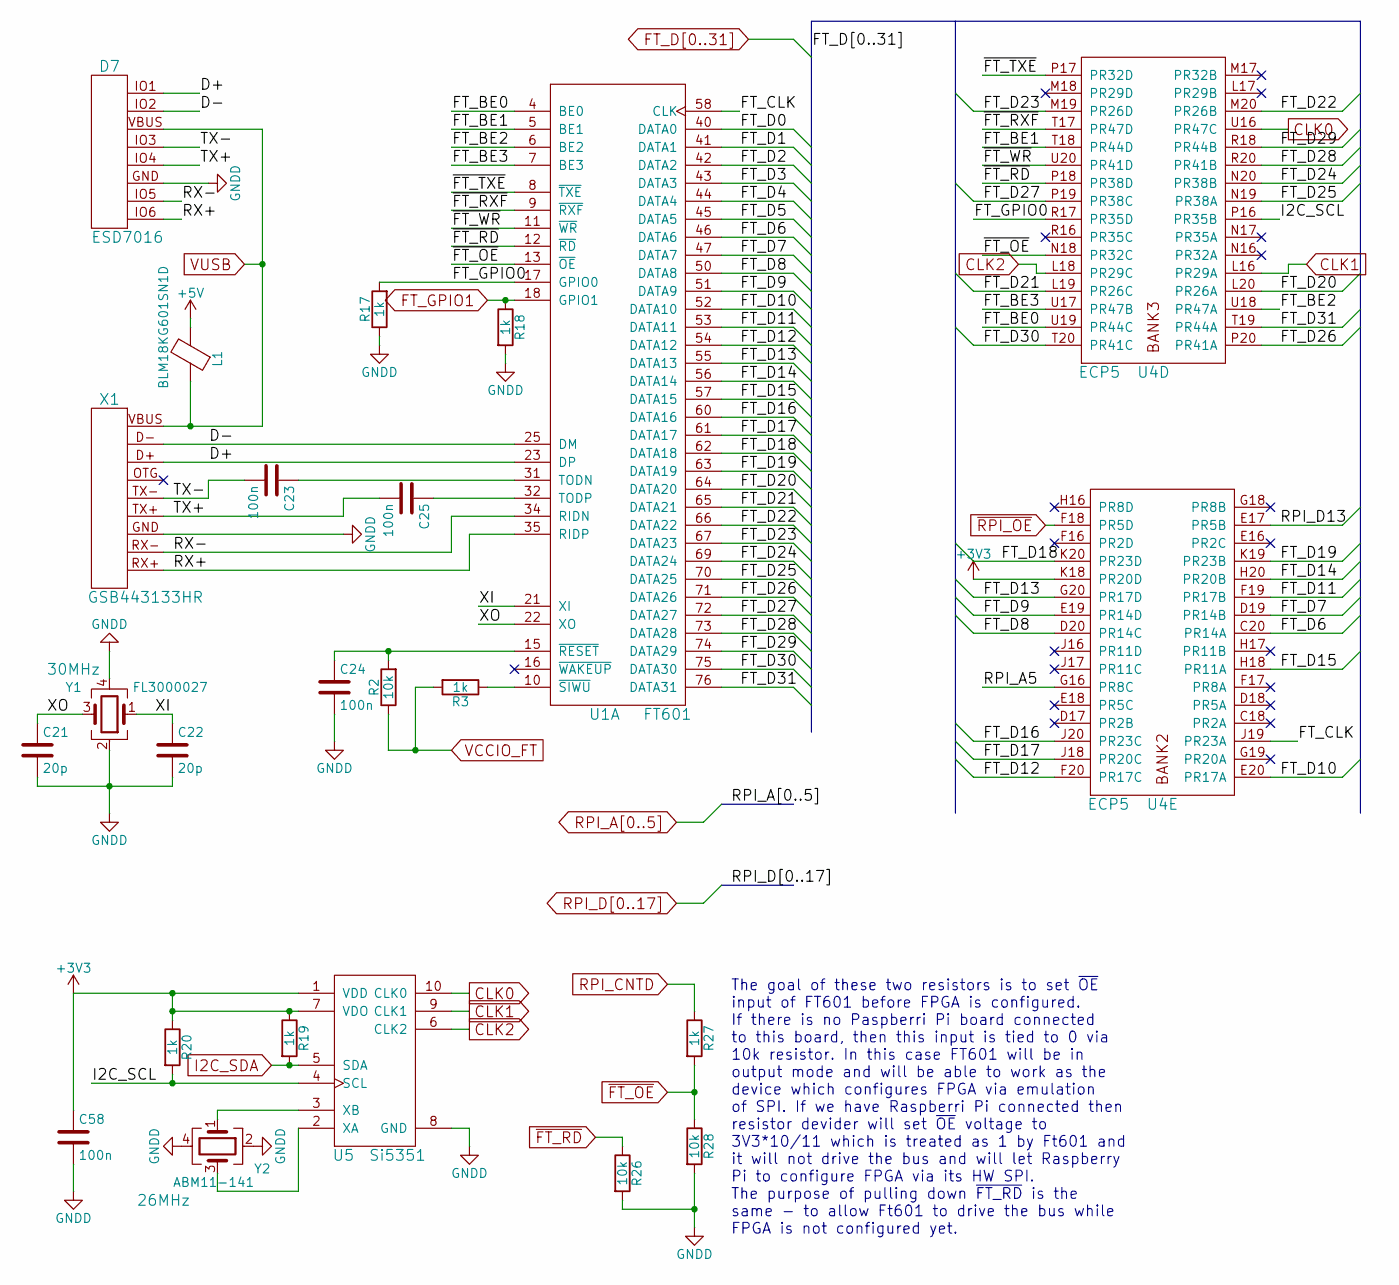
[picture p4: schematic FT601.sch, SDR]

Parts:
C21, C22: 20p; C_0603
C23, C24, C25, C58: 100n; C_0603
D7: ESD7016
L1: BLM18KG601SN1D; L_0805
R2, R26, R28: 10k; R_0603
R3, R17, R18, R19, R20, R27: 1k; R_0603
U1: FT601; QFN_76
U4: ECP5; ECP5_381
U5: Si5351; MSOP-10_3x3mm_Pitch0.5mm
X1: GSB443133HR; USB3_microB
Y1: FL3000027; Crystal_SMD_3225-4pin_3.2x2.5mm
Y2: ABM11-141; Crystal_SMD_2016-4pin_2.0x1.6mm

Connections:
+5V: L1.2; also elsewhere on the board
/FT601/D+: D7.IO1, U1.23 (DP), X1.D+
/FT601/D-: D7.IO2, U1.25 (DM), X1.D-
/FT601/FT_BE0: U1.4 (BE0), U4.U19 (PR44C)
/FT601/FT_BE1: U1.5 (BE1), U4.T18 (PR44D)
/FT601/FT_BE2: U1.6 (BE2), U4.U18 (PR47A)
/FT601/FT_BE3: U1.7 (BE3), U4.U17 (PR47B)
/FT601/FT_CLK: U1.58 (CLK), U4.J19 (PR23A)
/FT601/FT_GPIO0: R17.2, U1.17 (GPIO0), U4.R17 (PR35D)
/FT601/I2C_SCL: R20.2, U4.P16 (PR35B), U5.4 (SCL)
/FT601/RX+: D7.IO6, U1.35 (RIDP), X1.RX+
/FT601/RX-: D7.IO5, U1.34 (RIDN), X1.RX-
/FT601/TX+: C25.2, D7.IO4, X1.TX+
/FT601/TX-: C23.2, D7.IO3, X1.TX-
/FT601/XI: C22.1, U1.21 (XI), Y1.1
/FT601/XO: C21.1, U1.22 (XO), Y1.3
/FT601/~FT_RXF: U1.9 (~RXF), U4.T17 (PR47D)
/FT601/~FT_TXE: U1.8 (~TXE), U4.P17 (PR32D)
/FT601/~FT_WR: U1.11 (~WR), U4.U20 (PR41D)
CFG_MCLK: U1.43 (DATA3); also elsewhere on the board
CFG_MISO: U1.40 (DATA0); also elsewhere on the board
CFG_MOSI: U1.44 (DATA4); also elsewhere on the board
CLK0: U4.U16 (PR47C), U5.10 (CLK0); also elsewhere on the board
CLK1: U4.L16 (PR29A), U5.9 (CLK1)
CLK2: U4.L18 (PR29C), U5.6 (CLK2)
FT_D1: U1.41 (DATA1); also elsewhere on the board
FT_D2: U1.42 (DATA2); also elsewhere on the board
FT_D5: U1.45 (DATA5); also elsewhere on the board
FT_D6: U1.46 (DATA6), U4.C20 (PR14A)
FT_D7: U1.47 (DATA7), U4.D19 (PR14B)
FT_D8: U1.50 (DATA8), U4.D20 (PR14C)
FT_D9: U1.51 (DATA9), U4.E19 (PR14D)
FT_D10: U1.52 (DATA10), U4.E20 (PR17A)
FT_D11: U1.53 (DATA11), U4.F19 (PR17B)
FT_D12: U1.54 (DATA12), U4.F20 (PR17C)
FT_D13: U1.55 (DATA13), U4.G20 (PR17D)
FT_D14: U1.56 (DATA14), U4.H20 (PR20B)
FT_D15: U1.57 (DATA15), U4.H18 (PR11A)
FT_D16: U1.60 (DATA16), U4.J20 (PR23C)
FT_D17: U1.61 (DATA17), U4.J18 (PR20C)
FT_D18: U1.62 (DATA18), U4.K20 (PR23D)
FT_D19: U1.63 (DATA19), U4.K19 (PR23B)
FT_D20: U1.64 (DATA20), U4.L20 (PR26A)
FT_D21: U1.65 (DATA21), U4.L19 (PR26C)
FT_D22: U1.66 (DATA22), U4.M20 (PR26B)
FT_D23: U1.67 (DATA23), U4.M19 (PR26D)
FT_D24: U1.69 (DATA24), U4.N20 (PR38B)
FT_D25: U1.70 (DATA25), U4.N19 (PR38A)
FT_D26: U1.71 (DATA26), U4.P20 (PR41A)
FT_D27: U1.72 (DATA27), U4.P19 (PR38C)
FT_D28: U1.73 (DATA28), U4.R20 (PR41B)
FT_D29: U1.74 (DATA29), U4.R18 (PR44B)
FT_D30: U1.75 (DATA30), U4.T20 (PR41C)
FT_D31: U1.76 (DATA31), U4.T19 (PR44A)
FT_GPIO1: R18.1, U1.18 (GPIO1); also elsewhere on the board
I2C_SDA: R19.2, U5.5 (SDA); also elsewhere on the board
unnamed: C23.1, U1.31 (TODN)
unnamed: C24.1, R2.2, U1.15 (~RESET)
unnamed: C25.1, U1.32 (TODP)
unnamed: R3.1, U1.10 (~SIWU)
unnamed: U5.2 (XA), Y2.3
unnamed: U5.3 (XB), Y2.1
RPI_A5: U4.G16 (PR8C); also elsewhere on the board
RPI_CNTD: R27.1; also elsewhere on the board
RPI_D13: U4.E17 (PR5B); also elsewhere on the board
VCCIO_FT: C58.1, R2.1, R3.2, R19.1, R20.1, U4.K18 (PR20D), U5.1 (VDD), U5.7 (VDO); also elsewhere on the board
~FT_OE: R27.2, R28.1, U1.13 (~OE), U4.N18 (PR32C)
~FT_RD: R26.1, U1.12 (~RD), U4.P18 (PR38D)
~RPI_OE: U4.F18 (PR5D); also elsewhere on the board

Notes on the sheet:
The goal of these two resistors is to set ~OE~ input of FT601 before FPGA is configured. If there is no Paspberri Pi board connected to this board, then this input is tied to 0 via 10k resistor. In this case FT601 will be in output mode and will be able to work as the device which configures FPGA v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

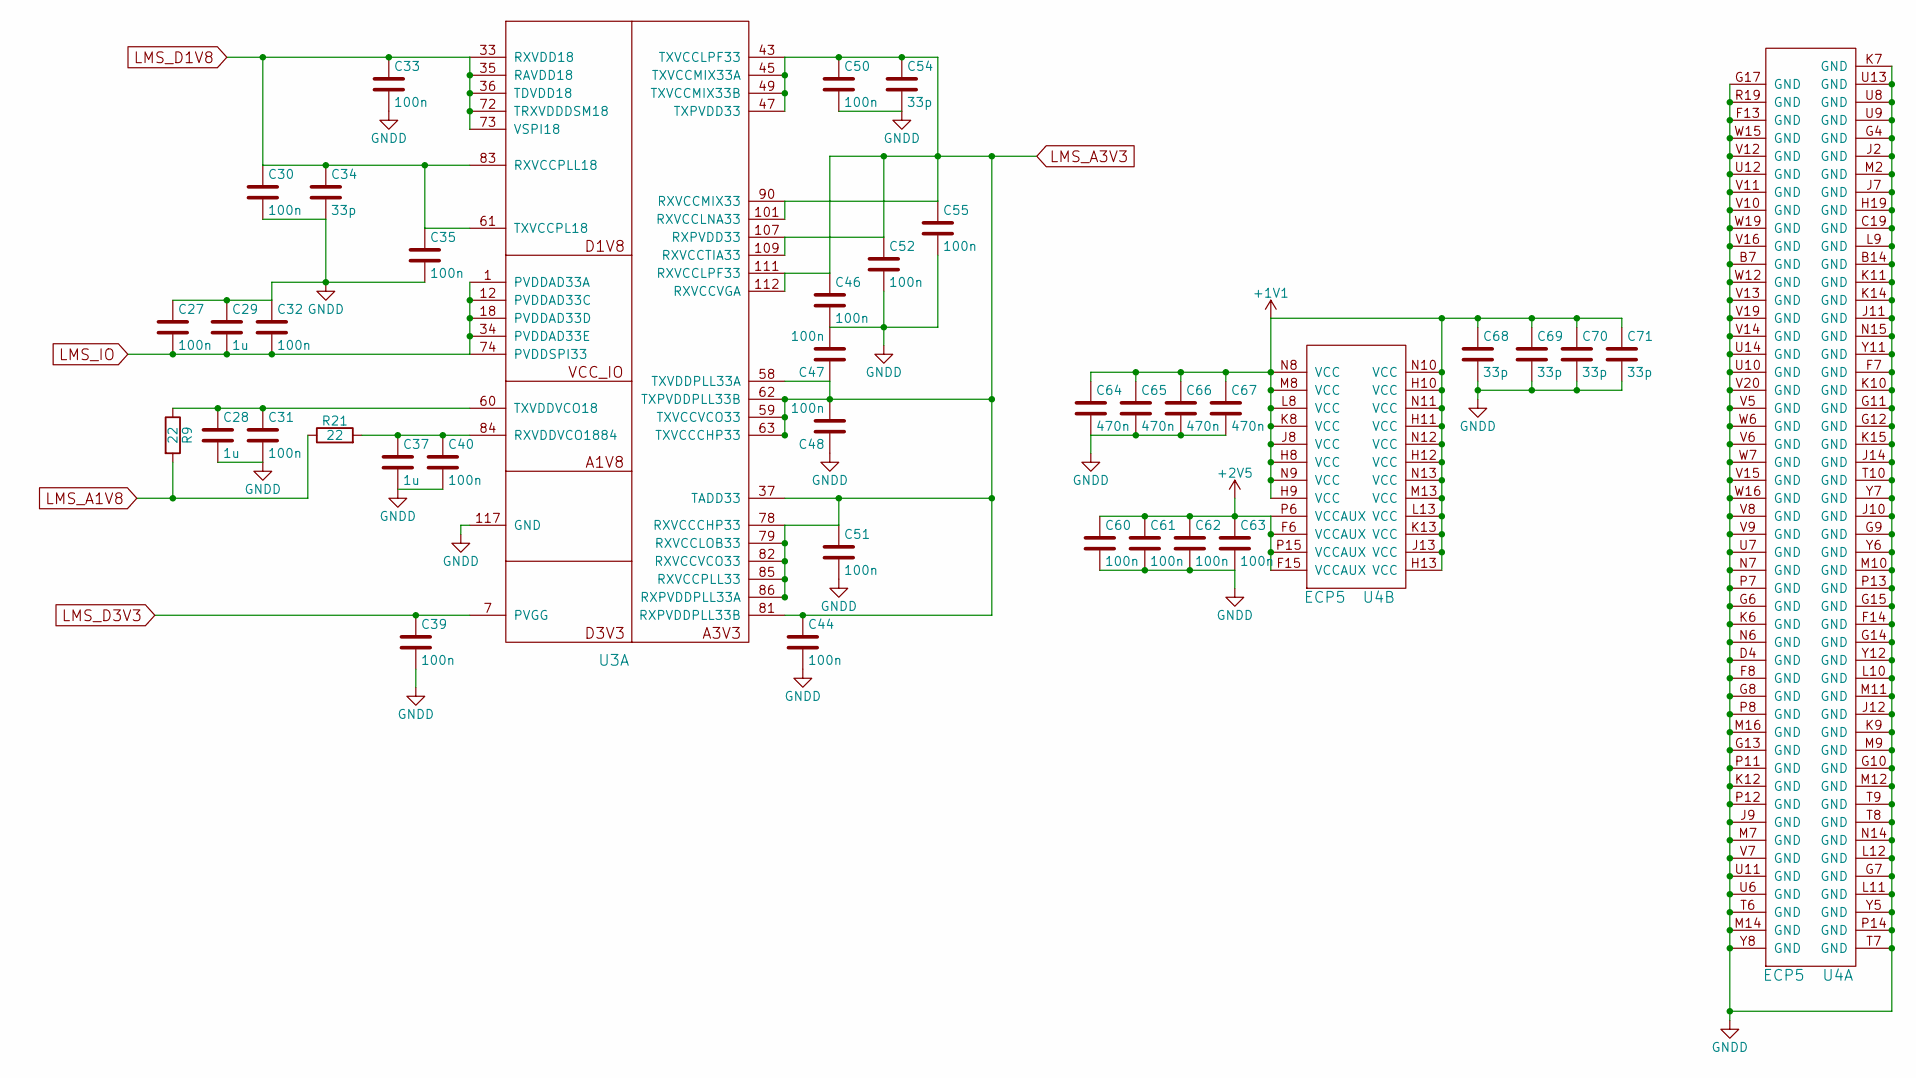
[picture p5: schematic power2.sch, SDR]

Parts:
C27, C30, C31, C32, C33, C35, C39, C40, C44, C46, C47, C48, C50, C51, C52, C55, C60, C61, C62, C63: 100n; C_0603
C28, C29, C37: 1u; C_0603
C34, C54, C68, C69, C70, C71: 33p; C_0603
C64, C65, C66, C67: 470n; C_0603
R9, R21: 22; R_0603
U3: LMS6002DR2; DQFN-120_via_off_pad; Manufacturer Part Number LMS6002DFN
U4: ECP5; ECP5_381

Connections:
+1V1: C64.1, C65.1, C66.1, C67.1, C68.1, C69.1, C70.1, C71.1, U4.H8 (VCC), U4.H9 (VCC), U4.H10 (VCC), U4.H11 (VCC), U4.H12 (VCC), U4.H13 (VCC), U4.J8 (VCC), U4.J13 (VCC), U4.K8 (VCC), U4.K13 (VCC), U4.L8 (VCC), U4.L13 (VCC), U4.M8 (VCC), U4.M13 (VCC), U4.N8 (VCC), U4.N9 (VCC), U4.N10 (VCC), U4.N11 (VCC), U4.N12 (VCC), U4.N13 (VCC); also elsewhere on the board
+2V5: C60.1, C61.1, C62.1, C63.1, U4.F6 (VCCAUX), U4.F15 (VCCAUX), U4.P6 (VCCAUX), U4.P15 (VCCAUX); also elsewhere on the board
LMS_A1V8: R9.2, R21.1; also elsewhere on the board
LMS_A3V3: C44.1, C46.1, C47.1, C48.2, C50.1, C51.1, C52.1, C54.1, C55.1, U3.37 (TADD33), U3.43 (TXVCCLPF33), U3.45 (TXVCCMIX33A), U3.47 (TXPVDD33), U3.49 (TXVCCMIX33B), U3.58 (TXVDDPLL33A), U3.59 (TXVCCVCO33), U3.62 (TXPVDDPLL33B), U3.63 (TXVCCCHP33), U3.78 (RXVCCCHP33), U3.79 (RXVCCLOB33), U3.81 (RXPVDDPLL33B), U3.82 (RXVCCVCO33), U3.85 (RXVCCPLL33), U3.86 (RXPVDDPLL33A), U3.90 (RXVCCMIX33), U3.101 (RXVCCLNA33), U3.107 (RXPVDD33), U3.109 (RXVCCTIA33), U3.111 (RXVCCLPF33), U3.112 (RXVCCVGA); also elsewhere on the board
LMS_D1V8: C30.1, C33.1, C34.1, C35.1, U3.33 (RXVDD18), U3.35 (RAVDD18), U3.36 (TDVDD18), U3.61 (TXVCCPL18), U3.72 (TRXVDDDSM18), U3.73 (VSPI18), U3.83 (RXVCCPLL18); also elsewhere on the board
LMS_D3V3: C27.2, C29.2, C32.2, C39.1, U3.1 (PVDDAD33A), U3.7 (PVGG), U3.12 (PVDDAD33C), U3.18 (PVDDAD33D), U3.34 (PVDDAD33E), U3.74 (PVDDSPI33); also elsewhere on the board
unnamed: C28.1, C31.1, R9.1, U3.60 (TXVDDVCO18)
unnamed: C37.1, C40.1, R21.2, U3.84 (RXVDDVCO1884)

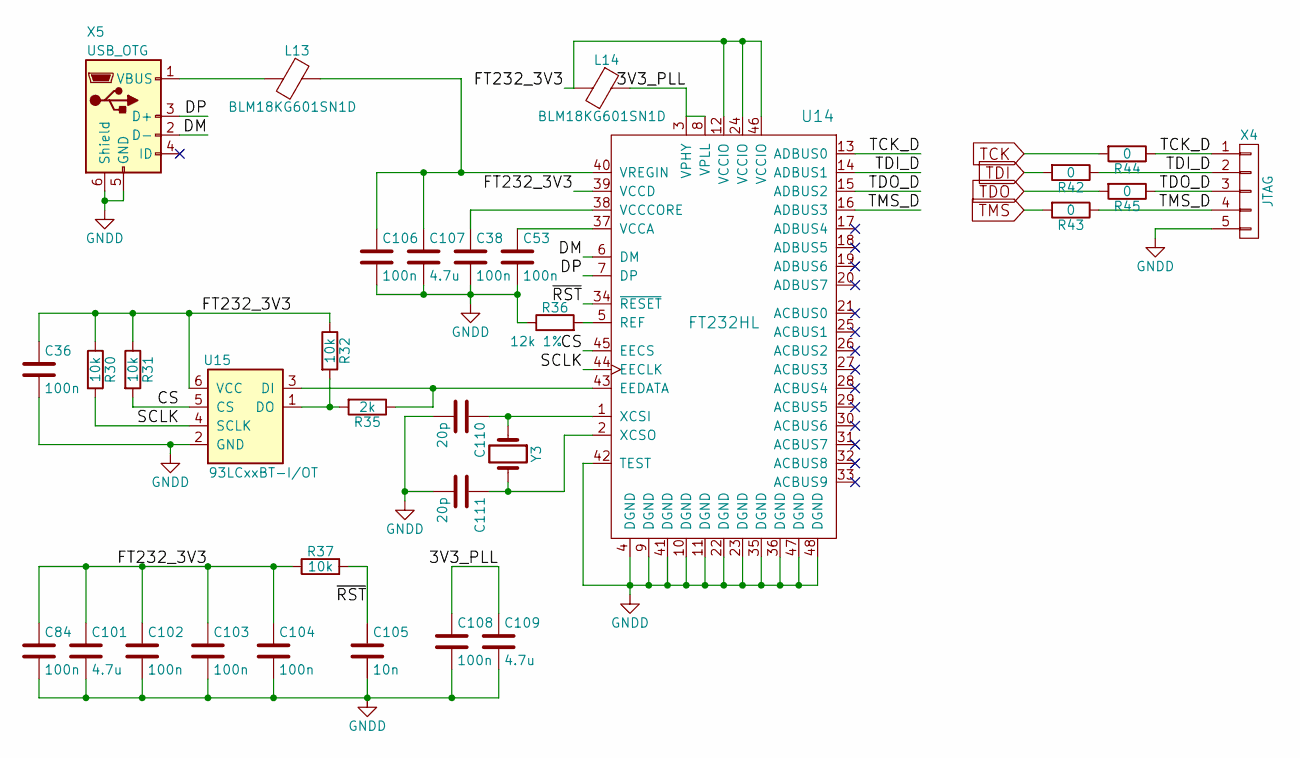
[picture p6: schematic ft232h.sch]

Parts:
C36, C38, C53, C84, C102, C103, C104, C106, C108: 100n; C_0603
C101, C107, C109: 4.7u; C_0603
C105: 10n; C_0603
C110, C111: 20p; C_0603
L13, L14: BLM18KG601SN1D; L_0805
R30, R31, R32, R37: 10k; R_0603
R35: 2k; R_0603
R36: 12k 1%; R_0603
R42, R43, R44, R45: 0; R_0603
U14: FT232HL; LQFP-48_7x7mm_Pitch0.5mm
U15: 93LCxxBT-I/OT; SOT-23-6
X4: JTAG; Pin_Header_Straight_1x05_Pitch1.27mm
X5: USB_OTG; USB_Mini-B
Y3: ABLS2-12.000MHZ-D4Y-T; Crystal_HC49-SD_SMD

Connections:
/ft232h/3V3_PLL: C108.1, C109.1, L14.1, U14.3 (VPHY), U14.8 (VPLL)
/ft232h/CS: R31.2, U14.45 (EECS), U15.5 (CS)
/ft232h/DM: U14.6 (DM), X5.2 (D-)
/ft232h/DP: U14.7 (DP), X5.3 (D+)
/ft232h/FT232_3V3: C36.1, C84.1, C101.1, C102.1, C103.1, C104.1, L14.2, R30.1, R31.1, R32.1, R37.1, U14.12 (VCCIO), U14.24 (VCCIO), U14.39 (VCCD), U14.46 (VCCIO), U15.6 (VCC)
/ft232h/SCLK: R30.2, U14.44 (EECLK), U15.4 (SCLK)
/ft232h/TCK_D: R44.1, U14.13 (ADBUS0), X4.1
/ft232h/TDI_D: R42.1, U14.14 (ADBUS1), X4.2
/ft232h/TDO_D: R45.1, U14.15 (ADBUS2), X4.3
/ft232h/TMS_D: R43.1, U14.16 (ADBUS3), X4.4
/ft232h/~RST: C105.1, R37.2, U14.34 (~RESET)
unnamed: C38.1, U14.38 (VCCCORE)
unnamed: C53.1, U14.37 (VCCA)
unnamed: C106.1, C107.1, L13.1, U14.40 (VREGIN)
unnamed: C110.1, U14.1 (XCSI), Y3.1
unnamed: C111.1, U14.2 (XCSO), Y3.2
unnamed: L13.2, X5.1 (VBUS)
unnamed: R32.2, R35.2, U15.1 (DO)
unnamed: R35.1, U14.43 (EEDATA), U15.3 (DI)
unnamed: R36.2, U14.5 (REF)
TCK: R44.2; also elsewhere on the board
TDI: R42.2; also elsewhere on the board
TDO: R45.2; also elsewhere on the board
TMS: R43.2; also elsewhere on the board

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
