jorikdima/sdr-pcb/sdr.kicad_pcb

## KiCad design sdr.kicad_pcb (continued)

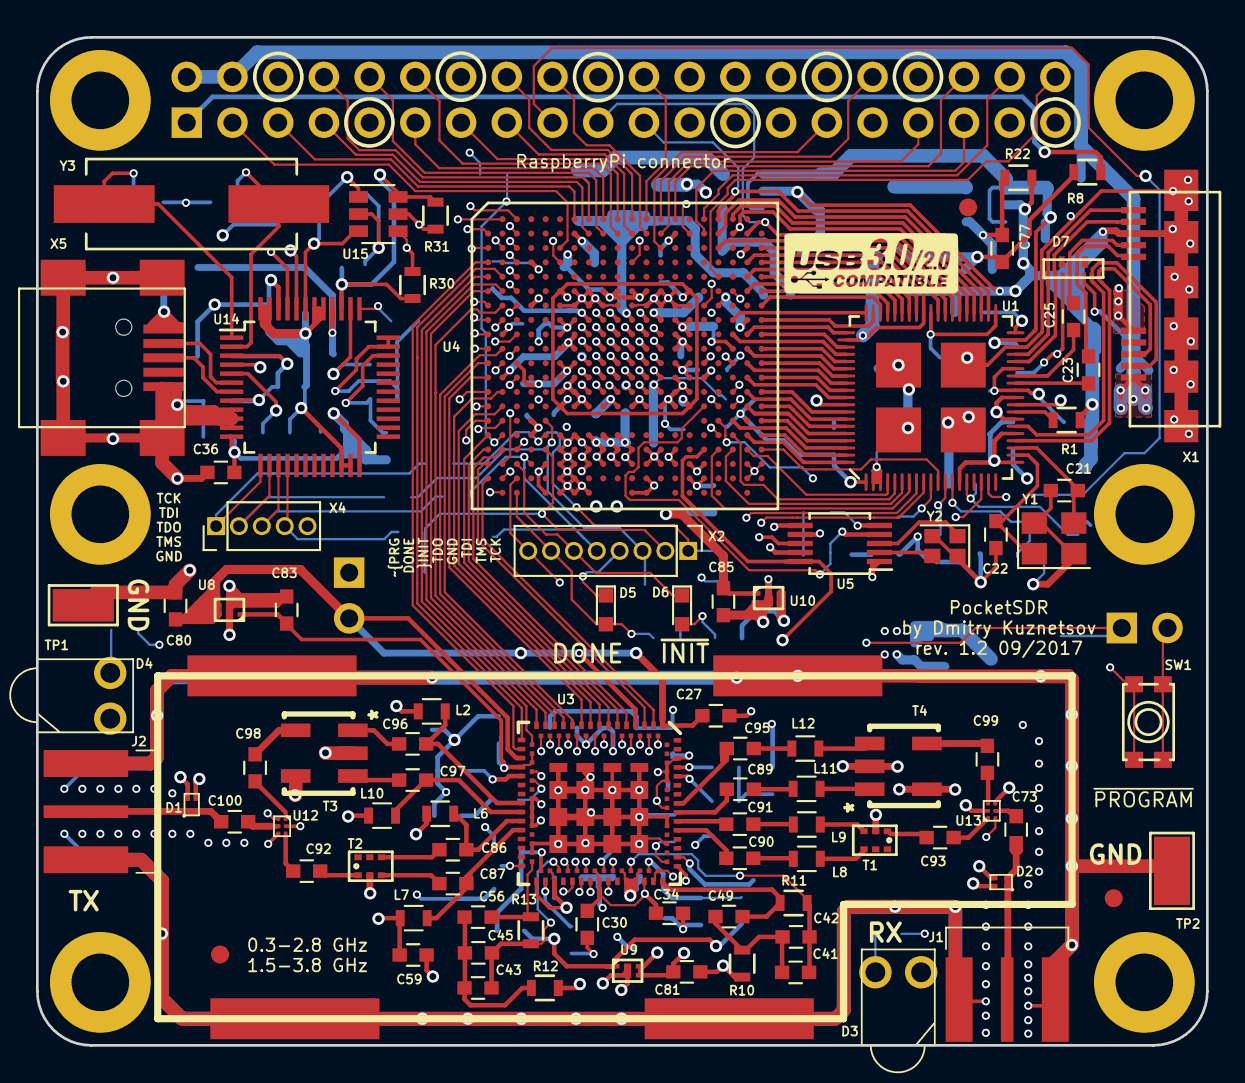
[picture p7: board sdr.kicad_pcb from above]

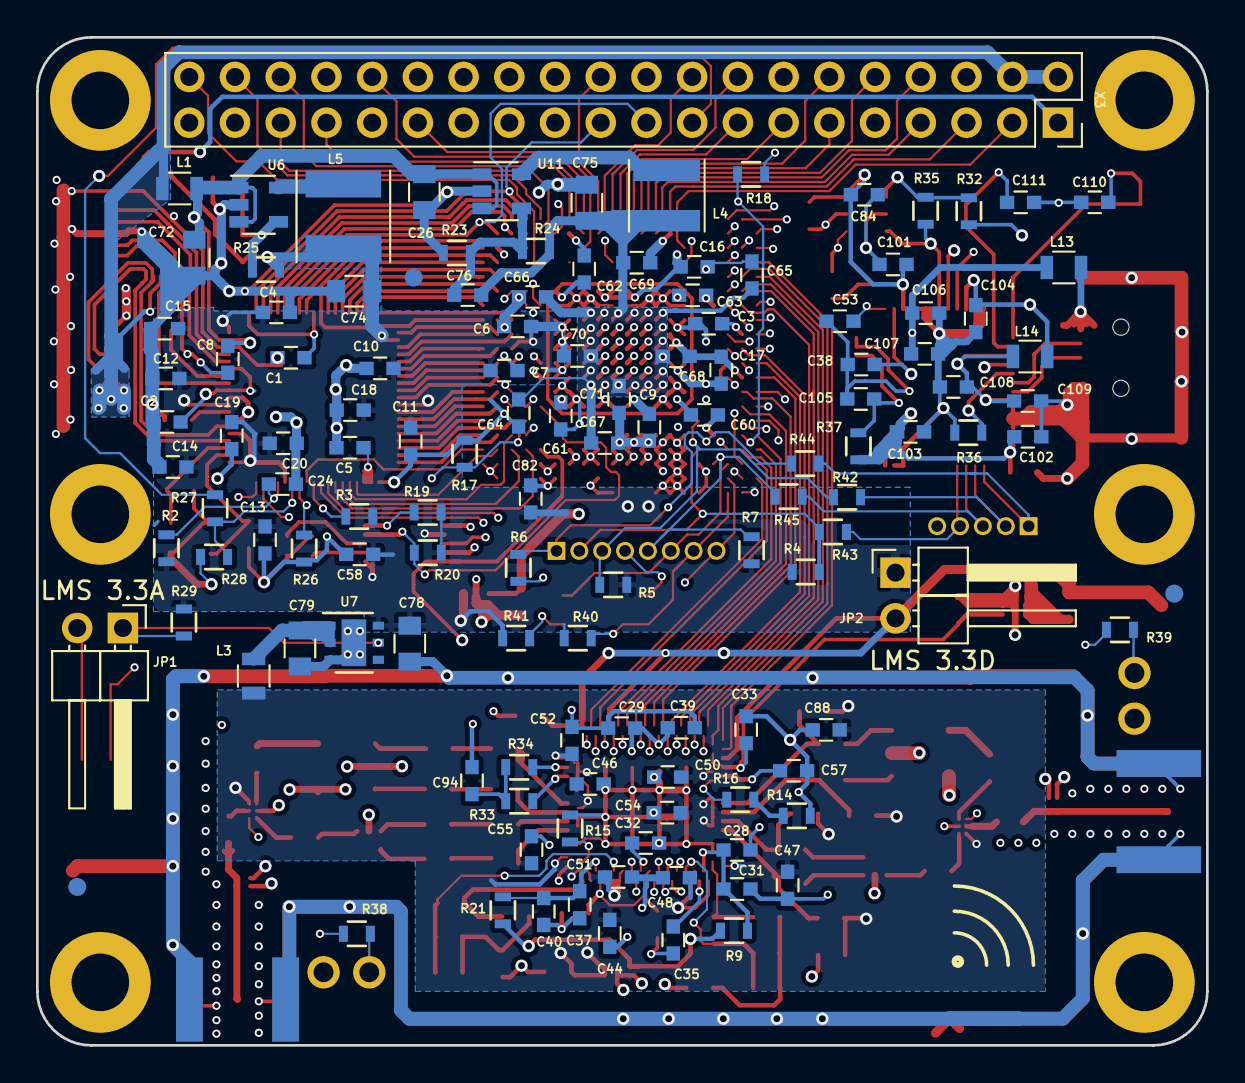
[picture p8: board sdr.kicad_pcb from below]

Board: 4 copper layers, 65.0 x 56.0 mm, 211 parts (125 on the bottom side), 223 nets.
