jorikdima/sdr-pcb/(commit log)

2017-02-07 Initial. FTDI schematic is done
    [FT601.sch, pwr.sch, sdr.kicad_pcb, sdr.sch]
2017-02-14 Cloack, LMS are added
    [FT601.sch, LMS6002.sch, RPi.sch, pwr.sch, sdr.kicad_pcb, sdr.sch]
2017-02-18 Schematic is done except RF.
    [FT601.sch, LMS6002.sch, RPi.sch, power2.sch, pwr.sch, sdr.kicad_pcb, sdr.sch]
2017-02-23 Placed most components for FTDI. Begin tracing FT601
    [FT601.sch, LMS6002.sch, RPi.sch, power2.sch, pwr.sch, sdr.kicad_pcb, sdr.sch]
2017-02-23 trace update
    [sdr.kicad_pcb]
2017-02-24 Just before FT_D tracing
    [sdr.kicad_pcb]
2017-03-03 Right before Sitch power retracing
    [FT601.sch, LMS6002.sch, RPi.sch, power2.sch, pwr.sch, sdr.kicad_pcb, sdr.sch]
2017-03-03 Power is traced. Placing capacitors for FPGA
    [pwr.sch, sdr.kicad_pcb]
2017-03-06 Caps for FPGA are placed. Most of FPGA power is traced. Need to trace Rpi connector
    [FT601.sch, LMS6002.sch, RPi.sch, power2.sch, pwr.sch, sdr.kicad_pcb]
2017-03-07 All traced except Rpi and LMS
    [FT601.sch, RPi.sch, sdr.kicad_pcb]
2017-03-08 RPI is almost finished
    [FT601.sch, RPi.sch, sdr.kicad_pcb]
2017-03-10 Everything is done except LMS and RF
    [FT601.sch, RPi.sch, sdr.kicad_pcb]
2017-03-22 Start placing RF. Shield is ready. Fixed some net bugs.
    [FT601.sch, LMS6002.sch, RPi.sch, power2.sch, pwr.sch, sdr.kicad_pcb]
2017-03-25 Right before switching to full RPi
    [LMS6002.sch, pwr.sch, sdr.kicad_pcb]
2017-03-25 Full Rpi beginning
    [sdr.kicad_pcb]
2017-05-17 Fix bug with not traced FT_TXE FT_RXF
    [FT601.sch, sdr.kicad_pcb]
2017-05-19 Finish tracing all except SDRAM and AFE
    [FT601.sch, RPi.sch, pwr.sch, sdr.kicad_pcb]
2017-05-23 Changed RF sheet to add second path to TX and RX
    [FT601.sch, LMS6002.sch, RPi.sch, power2.sch, pwr.sch, sdr.kicad_pcb]
2017-05-23 Small changes
    [FT601.sch, LMS6002.sch, RPi.sch, power2.sch, pwr.sch]
2017-05-24 Preliminary placing top layer of RF
    [LMS6002.sch, RPi.sch, sdr.kicad_pcb, sdr.sch]
2017-05-31 Placement of RF is on going.
    [FT601.sch, LMS6002.sch, RPi.sch, power2.sch, pwr.sch, sdr.kicad_pcb]
2017-06-03 Add jumpers for LMS power Traced most nets in LMS digital
    [FT601.sch, LMS6002.sch, RPi.sch, power2.sch, pwr.sch, sdr.kicad_pcb]
2017-06-04 Placement of all passive is finished. Tracing of most passive is finished. RF is not started yet.
    [FT601.sch, LMS6002.sch, RPi.sch, power2.sch, pwr.sch, sdr.kicad_pcb]
2017-06-06 Fix LMS_3V3A enable pull. Corrected shield ground
    [FT601.sch, LMS6002.sch, RPi.sch, ft232h.sch, power2.sch, pwr.sch, sdr.kicad_pcb]
2017-06-07 Add schematic of FT232H. Not placed yet.
    [FT601.sch, LMS6002.sch, ft232h.sch, pwr.sch, sdr.kicad_pcb]
2017-06-08 Add leds. Traced LMS_3V3A LDO.
    [RPi.sch, pwr.sch, sdr.kicad_pcb]
2017-06-09 Start tracing IO Fix connector for Rpi Use LED indicator for TX/RX LEDs
    [FT601.sch, LMS6002.sch, RPi.sch, ft232h.sch, power2.sch, pwr.sch, sdr.kicad_pcb]
2017-06-09 Add VCCIO and some vias
    [FT601.sch, RPi.sch, sdr.kicad_pcb]
2017-06-10 Finish tracing IO
    [FT601.sch, RPi.sch, ft232h.sch, power2.sch, sdr.kicad_pcb]
2017-06-10 Changed couple of pins
    [RPi.sch, sdr.kicad_pcb]
2017-06-10 FT232H has been finished Not finished: - PROGRAMN button - silkscreen preparation - RF
    [FT601.sch, RPi.sch, ft232h.sch, pwr.sch, sdr.kicad_pcb]
2017-06-12 Changed JTAG, added 0 Ohm resistors
    [ft232h.sch, pwr.sch, sdr.kicad_pcb]
2017-06-13 Place RefDes on the top of the board.
    [sdr.kicad_pcb]
2017-06-13 Button is traced. Everything's ready to trace RF.
    [pwr.sch, sdr.kicad_pcb]
2017-06-15 Added reference points. Right before RF tracing.
    [pwr.sch, sdr.kicad_pcb]
2017-06-16 Finish tracing. No DRC errors or unconnected nets. Put 2.5V reg on the top layer. Need to place RefDes on RF parts.
    [LMS6002.sch, sdr.kicad_pcb]
2017-06-17 Finish silkscreen layer.
    [LMS6002.sch, ft232h.sch, pwr.sch, sdr.kicad_pcb]
2017-06-19 Prepared BOM and changed some part numbers for unpopular ones. Added manufacture PN for each part.
    [FT601.sch, LMS6002.sch, RPi.sch, ft232h.sch, power2.sch, pwr.sch, sdr.kicad_pcb, sdr.sch]
2017-06-19 Changed mask on LMS footprint.
    [sdr.kicad_pcb]
2017-06-19 Fix inductors RefDes silkscreen
    [sdr.kicad_pcb]
2017-06-20 Add logo, rev. GND testpoints etc in silkscreen.
    [FT601.sch, LMS6002.sch, RPi.sch, ft232h.sch, power2.sch, pwr.sch, sdr.kicad_pcb]
2017-06-20 Fix shield. Added BOM
    [BOM_sdr.xls, sdr.kicad_pcb]
2017-06-22 Fix shield lines again.
    [BOM_sdr.xls, sdr.kicad_pcb]
2017-07-21 Start fixing problems with mask size and copper zone clearance.
    [sdr.kicad_pcb]
2017-07-22 Finish fixing problems: 1. LDO 3V3A has been changed as well as it CAPs 2. Silkscreen fixed 3. Mask expansion is changed
    [FT601.sch, LMS6002.sch, RPi.sch, ft232h.sch, power2.sch, pwr.sch, sdr.kicad_pcb]
2017-07-22 Fix silkscreen of update components. Fix width of fan outs of RF muxers to better soldering.
    [sdr.kicad_pcb]
2017-07-24 Change footprints for LMS and FT601 to allow mask resist between pads. Now only ESD7016 and RF muxers have no mask due to very low pitch.
    [sdr.kicad_pcb]
2017-07-24 Updated solder paste layers. Fix OSC components adding solder paste.
    [sdr.kicad_pcb]
2017-08-10 Update solder paste layer for components. Reduced width of tracks where they were wider than pads. Add mounting holes on paste layers.
    [sdr.kicad_pcb]
2017-08-18 Update solder paste layers to reduce paste amount on some components and remove paste but not drill hole) on mount holes. Updated BOM. Removed deadend line on PCB. Add GND layer on Layer 3.
    [BOM_sdr.xls, sdr.kicad_pcb]
2017-08-23 Fix USB mini B mount holes.
    [sdr.kicad_pcb]
2017-08-25 Small upgrade to make GND polygon on layer 3 more solid.
    [sdr.kicad_pcb]
2017-08-25 Moved R1 to the same layer as FT600. Rotated Y1.
    [sdr.kicad_pcb]
